Sletten/STM_Perf/Hardware/BOM.txt

List of components used in the perf module, divided into each pcb.

Motherboard:
STM32F100ZET6B		x3
http://no.farnell.com/stmicroelectronics/stm32f100zet6b/mcu-32bit-cortex-m3-24mhz-lqfp/dp/1898999

-EEPROM
24LC256-I/SN 256Kb	x3
http://no.farnell.com/microchip/24lc256-i-sn/serial-eeprom-256kbit-400khz-soic/dp/9757996

-3.3V regulator		x3
TEXAS INSTRUMENTS  LM2937IMP-3.3/NOPB  LDO REGULATOR, 3.3V, 0.5A, 3SOT223
http://no.farnell.com/texas-instruments/lm2937imp-3-3-nopb/ldo-regulator-3-3v-0-5a-3sot223/dp/2296021

-thruster levelshift
SN74LVCC4245APWR	x3
http://no.farnell.com/texas-instruments/sn74lvcc4245apwr/ic-8bit-bus-transceiver-tssop/dp/2342538

crystall		x3

http://no.farnell.com/abracon/abl-24-000mhz-b2/crystal-24m-18pf-cl-hc49-4h/dp/1611782

LEd

green 	x10
http://no.farnell.com/kingbright/kpt-3216sgc/led-1206-green-12mcd-568nm/dp/2099247

red	x10
http://no.farnell.com/kingbright/kpt-3216ec/led-1206-red-15mcd-625nm/dp/2099245

yellow	x5
http://no.farnell.com/kingbright/kpt-3216syck/led-yellow-1206-smd/dp/2099249

orange	x5
http://no.farnell.com/kingbright/kpt-3216seck/led-orange-1206-smd/dp/2099246

Resistor

4,7k 	x 20
http://no.farnell.com/multicomp/mcwr12x4701ftl/res-thick-film-4-7kohm-1-0-25w/dp/2447523

64,9 	x 20
http://no.farnell.com/multicomp/mc0125w1206164r9/resistor-64r9-0-125w-1-1206/dp/2142125

140	x20
http://no.farnell.com/multicomp/mc0125w12061140r/resistor-140r-0-125w-1-1206/dp/2142139

150	x20
http://no.farnell.com/multicomp/mc0125w12061150r/resistor-150r-0-125w-1-1206/dp/9335943

56	x20
http://no.farnell.com/multicomp/mc0125w1206156r/resistor-56r-0-125w-1-1206/dp/9336702

59	x20
http://no.farnell.com/multicomp/mc0125w1206159r0/resistor-59r-0-125w-1-1206/dp/2142123

Capasitor

100n 	x40
http://no.farnell.com/multicomp/mc0805b104k500ct/cap-mlcc-x7r-100nf-50v-0805/dp/1759265
10µ	x15
http://no.farnell.com/multicomp/mc0805x106k250ct/cap-mlcc-x5r-10uf-25v-0805/dp/2320833
27p	x20
http://no.farnell.com/multicomp/mc0805n270j500ct/cap-mlcc-c0g-np0-27pf-50v-0805/dp/1759196
1µ	x10
http://no.farnell.com/kemet/c0805c105k3ractu/cap-mlcc-x7r-1uf-25v-0805/dp/2395779
10n	x10
http://no.farnell.com/multicomp/mc0805b103k500ct/cap-mlcc-x7r-10nf-50v-0805/dp/1759246

Pin Headers:

4x1 header	x10
http://no.farnell.com/multicomp/2211s-04g/connector-header-tht-2-54mm-4way/dp/1593413

20x2 socket 	x6
http://no.farnell.com/harwin/m20-7832046/socket-pcb-0-1-20-20way/dp/7992033
header		x4
http://no.farnell.com/molex/10-89-7402/connector-header-40pos-2row-2/dp/2396214

3x2 socket	x10
http://no.farnell.com/multicomp/2213s-06g/header-2-row-vert-6way/dp/1593440
header		x5
http://no.farnell.com/multicomp/2214s-06sg-85/connector-receptacle-pcb-2-54mm/dp/1593488

2x16		x10
http://no.farnell.com/samtec/ces-116-01-t-d/receptacle-2-54mm-dual-32way/dp/1667521
		x10
http://no.farnell.com/wurth-elektronik/61303221021/header-2-54mm-pin-tht-r-a-32way/dp/2356204

connectors
Headers

2pin	x2
http://no.farnell.com/multicomp/mc000128/terminal-block-header-2pos-th/dp/2008108

5pin	x4
http://no.farnell.com/multicomp/mc000131/terminal-block-header-5pos-th/dp/2008111

10pin	x2
http://no.farnell.com/multicomp/mc000134/terminal-block-header-10pos-th/dp/2008114

pluggable

2pin	x2
http://no.farnell.com/multicomp/mc000096/terminal-block-pluggable-2pos/dp/2008072

5pin	x4
http://no.farnell.com/multicomp/mc000099/terminal-block-pluggable-5pos/dp/2008076

10pin	x2
http://no.farnell.com/multicomp/mc000102/terminal-block-pluggable-10pos/dp/2008079

Backplane:

Power:

Com:

manip:

light:

aux1:

aux2:
