Sletten/STM_Perf/Documentation/communication protocol.txt

communication protocol for PERF module, based on MIP data communications protocol.

Packet overciew

	Header

-Start of Packet (SOP)
One or two bytes of bit sequence, (characters) to innitiate the start of a packet
Startbyte 1: 155
Startbyte 2: 185

-Data type byte
Two bytes describing what type of data is being sendt.
First one byte describing command type
- COMMAND		Genreal system commands, retrieving info, performing system test, and such
- CONTROL		Controlling systems, like thruster, manip, light
- SENSOR		Retrieving data from sensor
- SYSTEM PARAMETER	Setting and reading system parameters stored in eeprom

Then one byte to describe what system to connect with.

- Thruster
- Manipulator
- Light
- Camera

-Payload Length byte
One byte which value indicates how many bytes is contained in the Payload.
Counting onlye the number of data bytes sendt, not to include the start header(startbytes, datatype, and length), or the checksum bytes

	Payload

-Payload header
applicable if data type indicates several types of data is sendt.
Data type byte, same as above.
Data length, the length of this payload chunk

-Payload data
The data sendt as payload, length described by previous byte.

	Checksum
Two bytes for checksum, might use 16-bit fletch checksum as described in the MIP reference

Table of data types:

commands		0x01
	Get system info
	get version
	get status

-Control		0x08
	thruster	0x11	- 6 bytes
		x y z axis
		yaw pitch roll rotation
	manip		0x13
		channel number, 1 byte - 8 possible active, (eg: 00101101, ch 1, 3, 4, 6 active)
		movement, speed/ set position/ force - givven by previous setup
	light		0x15
		channel number, 1 byte - 8 possible active, (eg: 00101101, ch 1, 3, 4, 6 active)
		set dim, two channels in one byte, 4bits per light channel.
	camera		0x17
		channel number, 1 byte - 8 possible active, (eg: 00101101, ch 1, 3, 4, 6 active)
		set position/ speed givven by setup.
		focus / zoom / other
	other		0x1F

-sensor				0x0F
	request data - one value for each type of equipment.
		-sonar
		-altimeter
		-imu

-system parameters	0x10 - set for now, 0x11 for save to eeprom
	thruster		0x11
		channel number, 1 byte - 8 possible active, (eg: 00101101, ch 1, 3, 4, 6 active)
		set midpoint
		set endpoint
		set deadzone
		set max power/thrust/
		set thrust vectoring
		set 
	manip			0x13
		channel number, 1 byte - 8 possible active, (eg: 00101101, ch 1, 3, 4, 6 active)
		set actuator type (motor/servo/stepper) // is this usefull? PERF firmware controls manip fuctionalyty anyways.
		set enpoints
		set max speed/power/
		set midpoint
		set 
	light			0x15
	camera			0x17
	other			0x1F

Thruster
