Sletten/STM_Perf/Hardware/KiCad/Perf/MB/New Folder/snapshot_a00.png

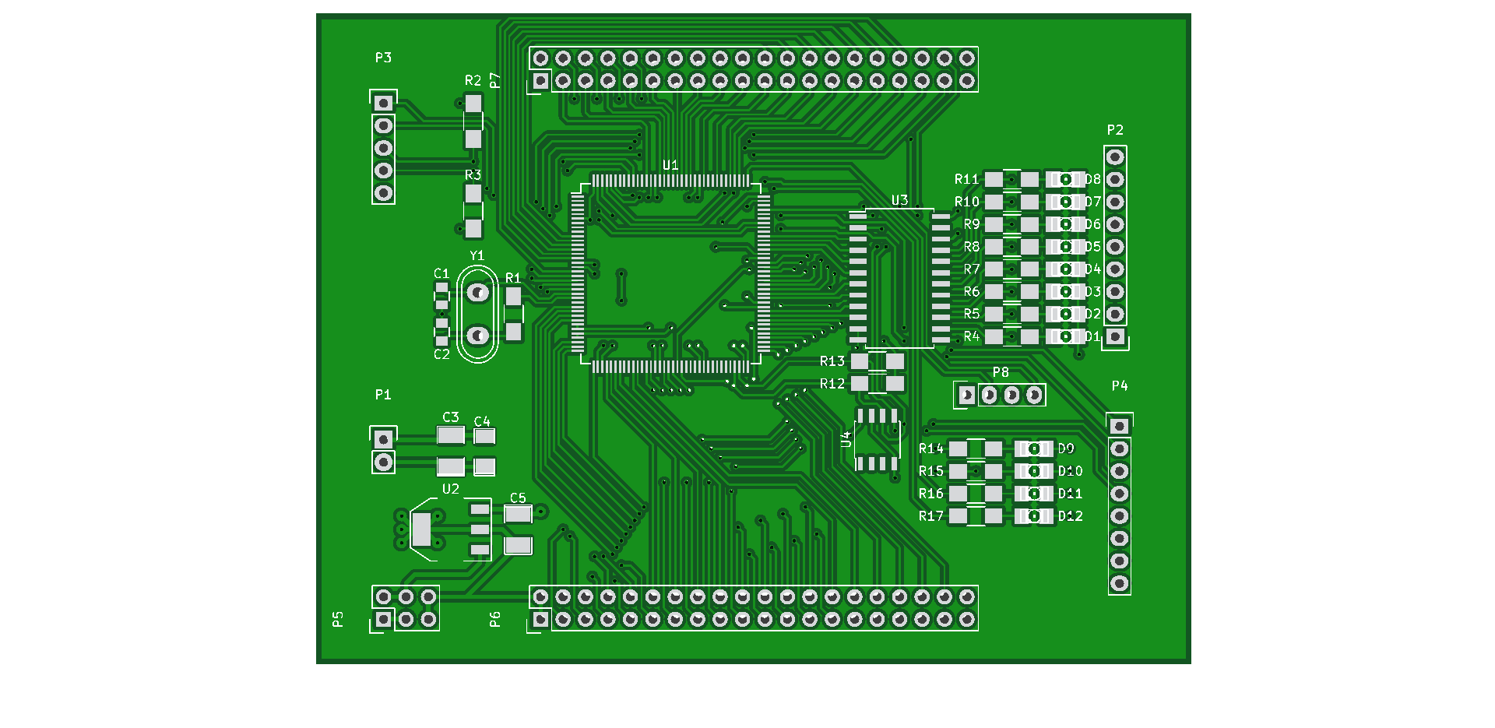
Hardware/KiCad/Perf/MB/New Folder/snapshot_a00.png
