Sletten/STM_Perf/Hardware/KiCad/Perf/MB/Motherboard.stl

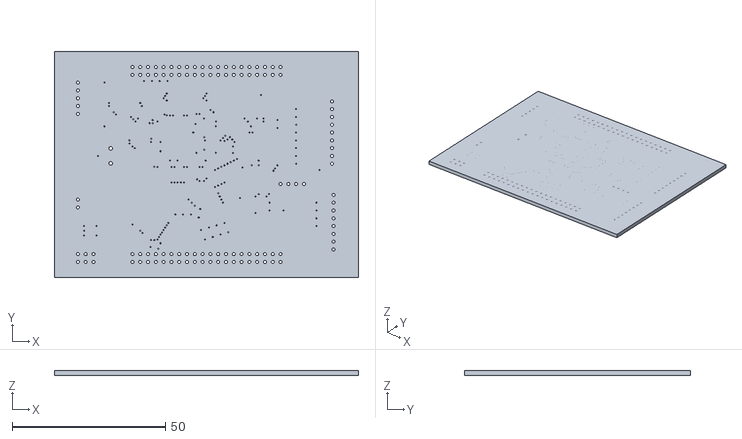
[picture p2: CAD file, 2015-05-25]
Hardware/KiCad/Perf/MB/Motherboard.stl
99.1 x 73.7 x 1.70
