Sletten/STM_Perf/(list of files, cad)

Other CAD files:
Hardware/KiCad/Perf/MB/New Folder/Motherboard.ply
