Sletten/STM_Perf/Hardware/KiCad/Perf/MB/New Folder/Motherboard-B_Cu.pdf

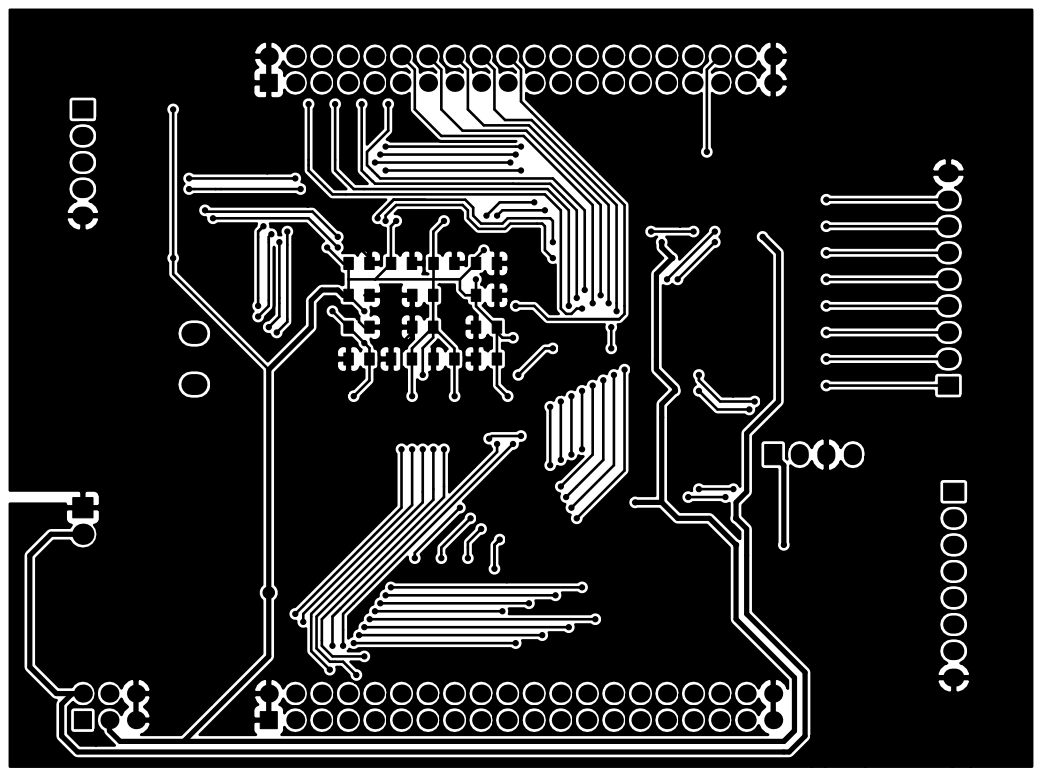
[picture p3: page 1]
