Sletten/STM_Perf/Hardware/KiCad/Perf/MB/New Folder/Motherboard-B_Mask.pdf

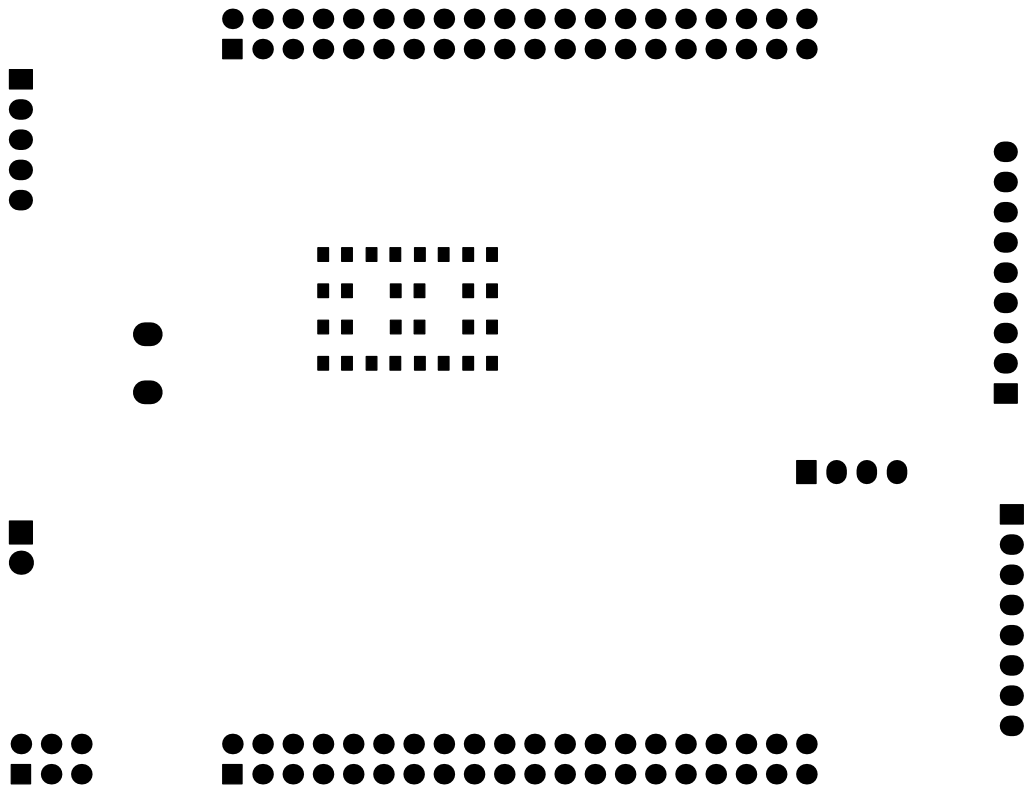
[picture p4: page 1]
