Sletten/STM_Perf/Hardware/KiCad/Perf/MB/New Folder/Motherboard-B_SilkS.pdf

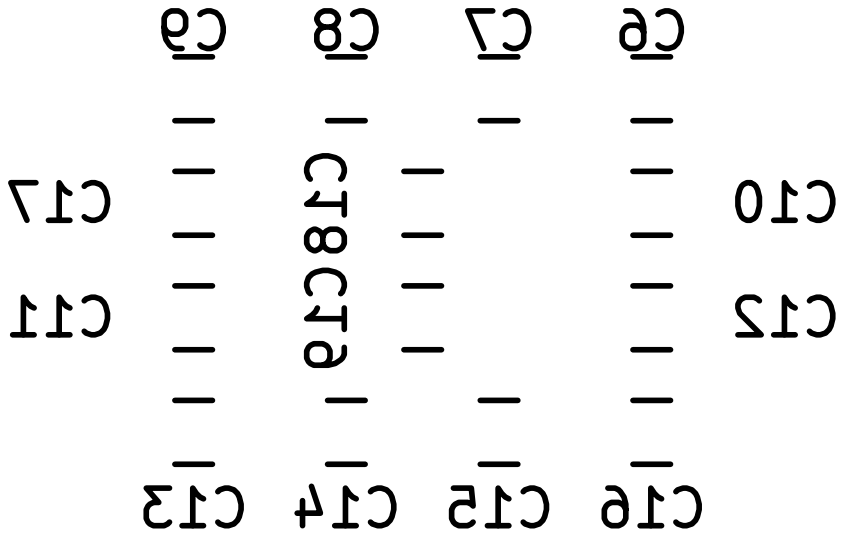
[picture p5: page 1]
