Sletten/STM_Perf/Hardware/KiCad/Perf/MB/New Folder/Motherboard-F_Cu.pdf

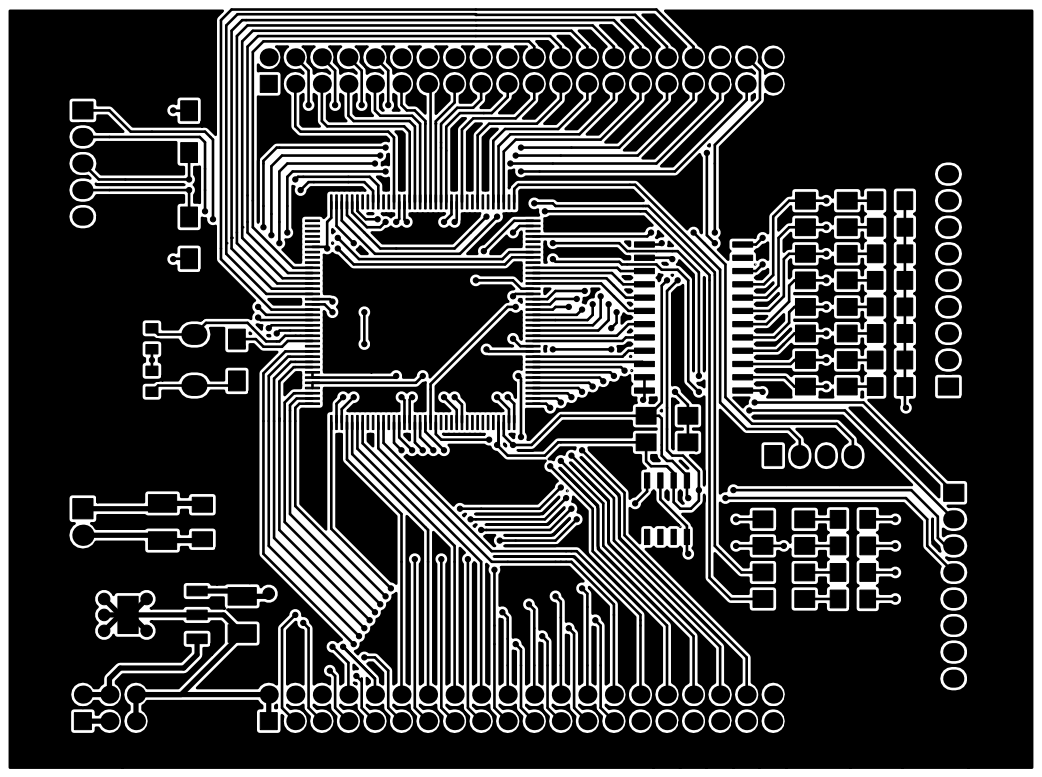
[picture p6: page 1]
