Sletten/STM_Perf/Hardware/KiCad/Perf/MB/New Folder/Motherboard-F_Mask.pdf

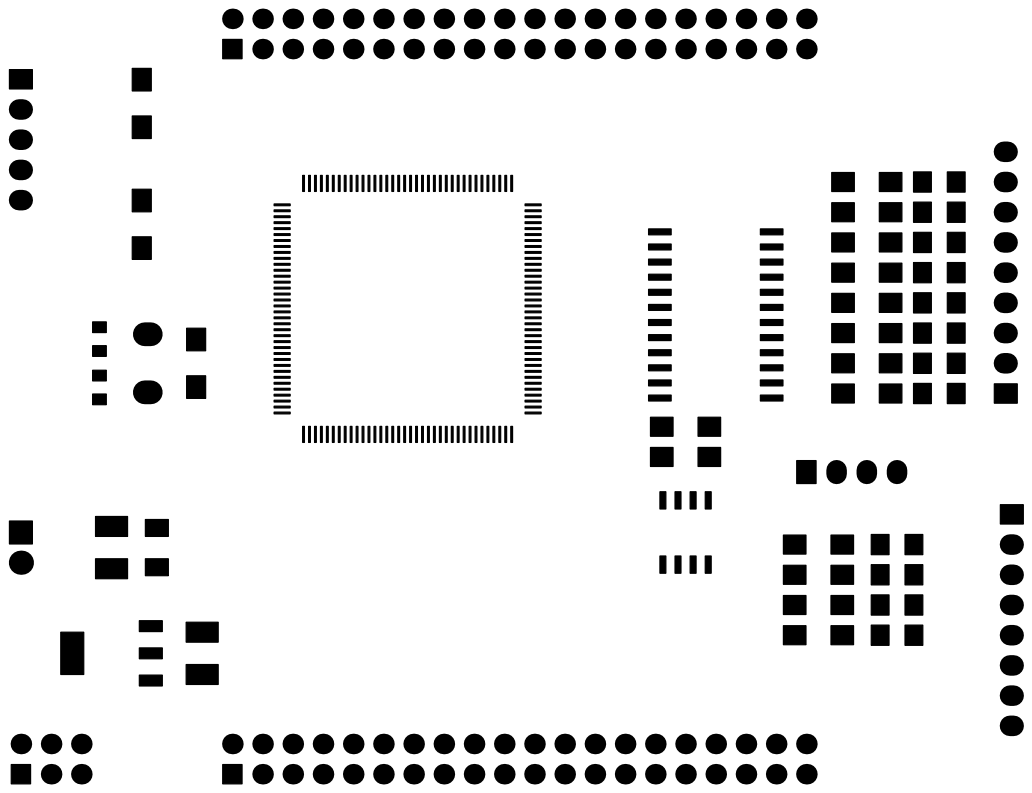
[picture p7: page 1]
