Sletten/STM_Perf/Hardware/KiCad/Perf/MB/New Folder/Motherboard-F_SilkS.pdf

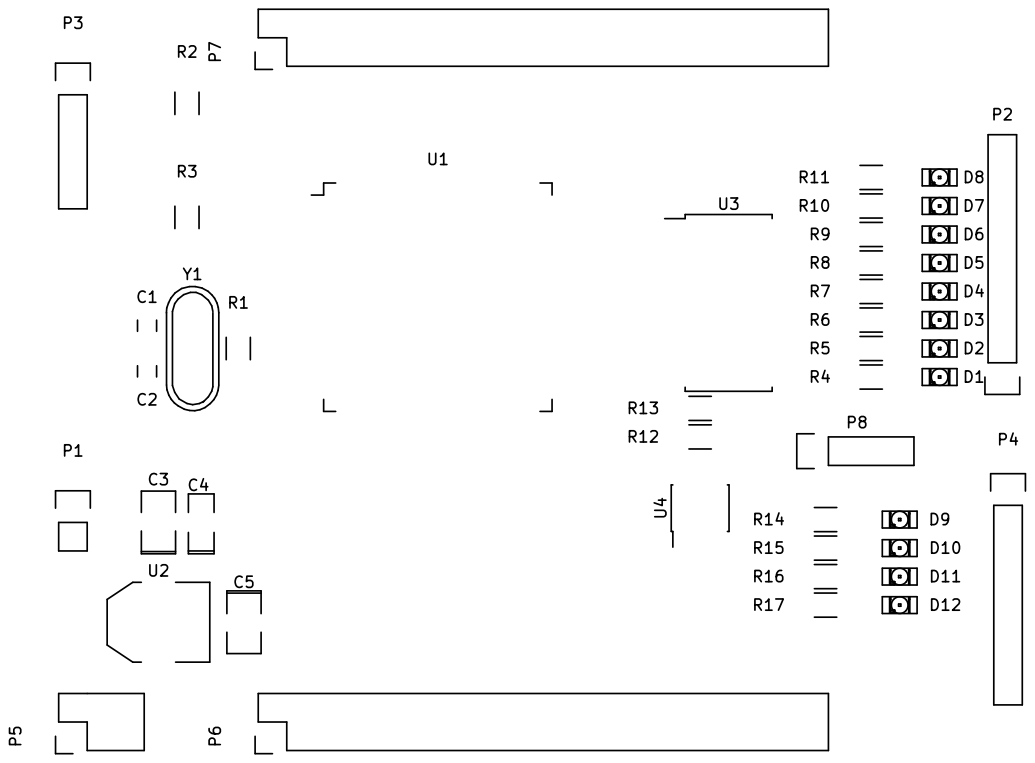
[picture p8: page 1]
