Sletten/STM_Perf/Hardware/KiCad/Perf/Gerber/MB/temp/Motherboard-B.Cu.pdf

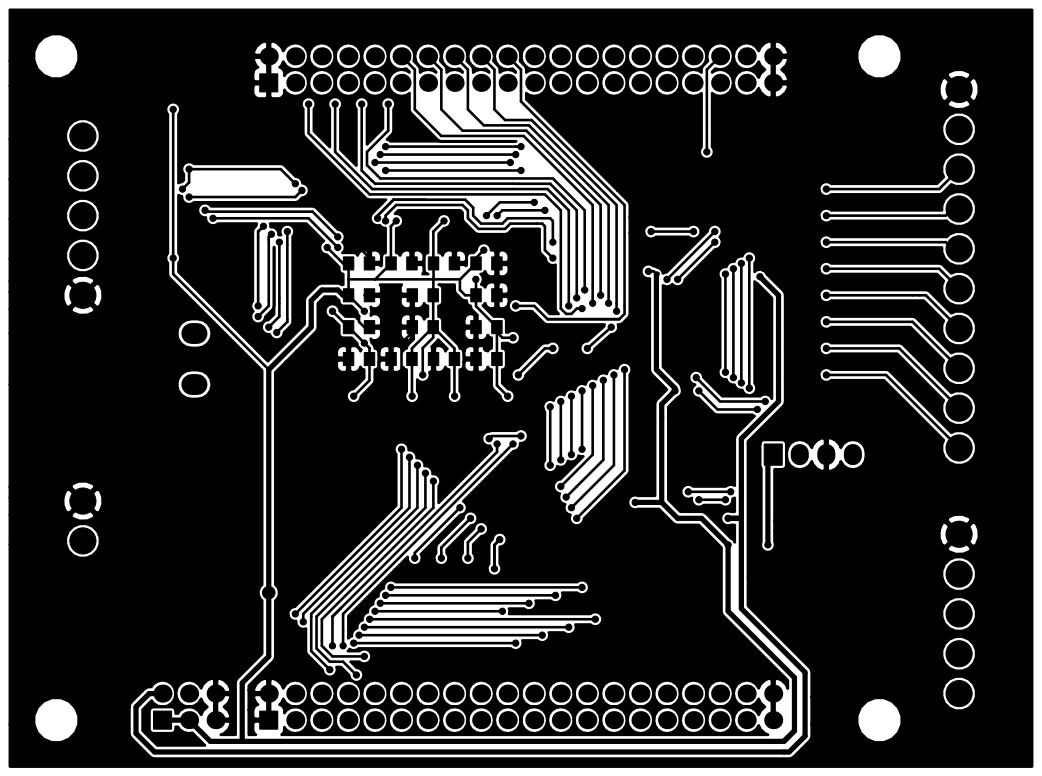
[picture p9: page 1]
