Sletten/STM_Perf/Hardware/KiCad/Perf/Gerber/MB/temp/Motherboard-B.Mask.pdf

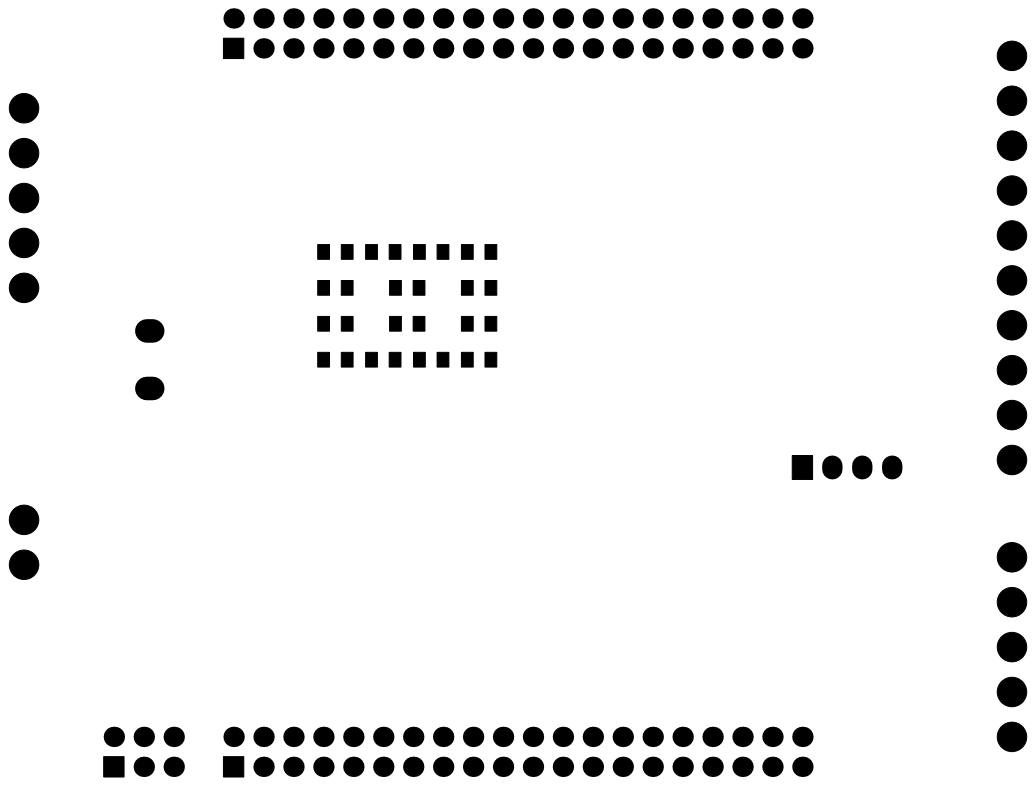
[picture p10: page 1]
