Sletten/STM_Perf/Hardware/KiCad/Perf/Gerber/MB/temp/Motherboard-B.SilkS.pdf

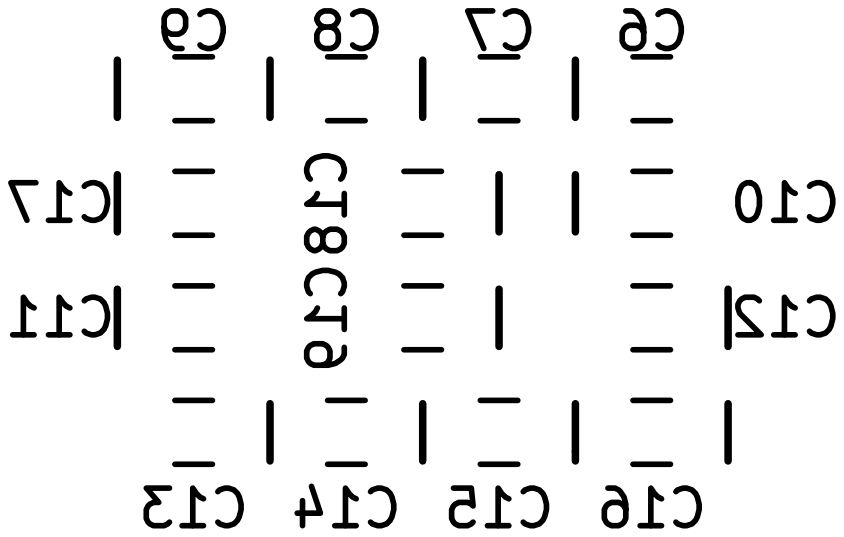
[picture p11: page 1]
