Sletten/STM_Perf/Hardware/KiCad/Perf/Gerber/MB/temp/Motherboard-Cmts.User.pdf

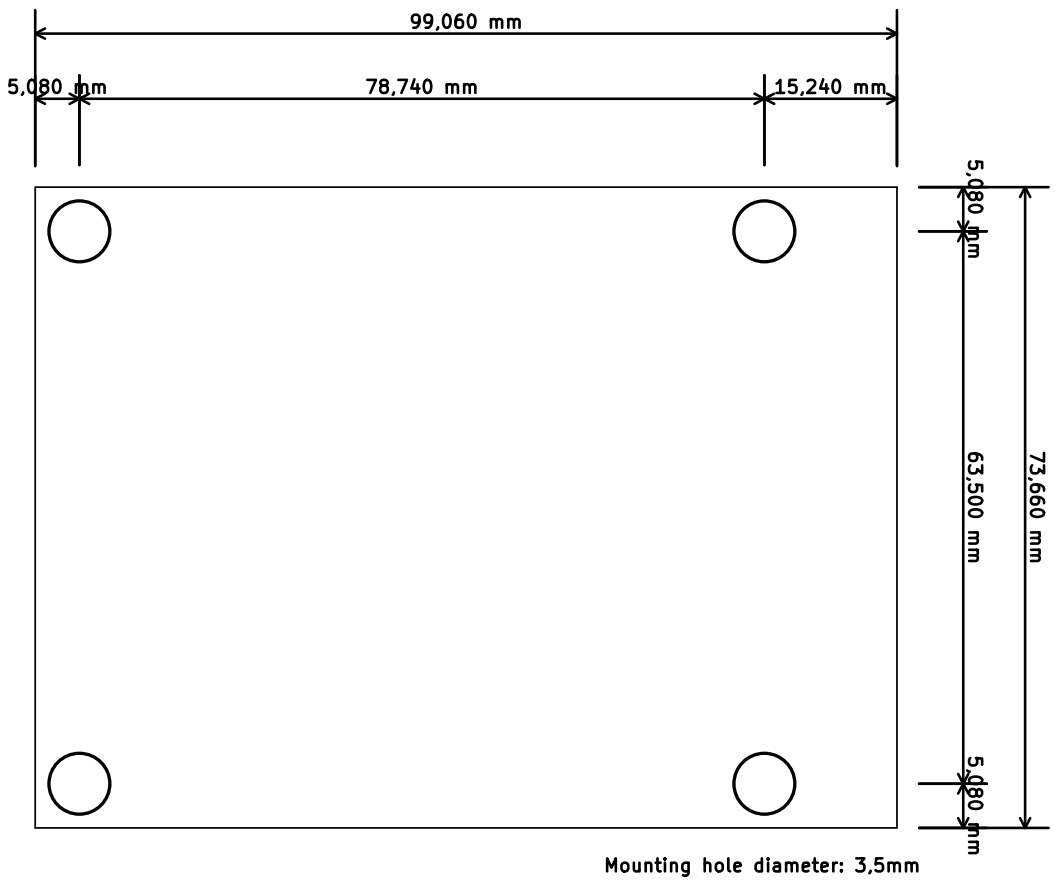
[picture p12: page 1]
