Sletten/STM_Perf/Hardware/KiCad/Perf/Gerber/MB/temp/Motherboard-F.Cu.pdf

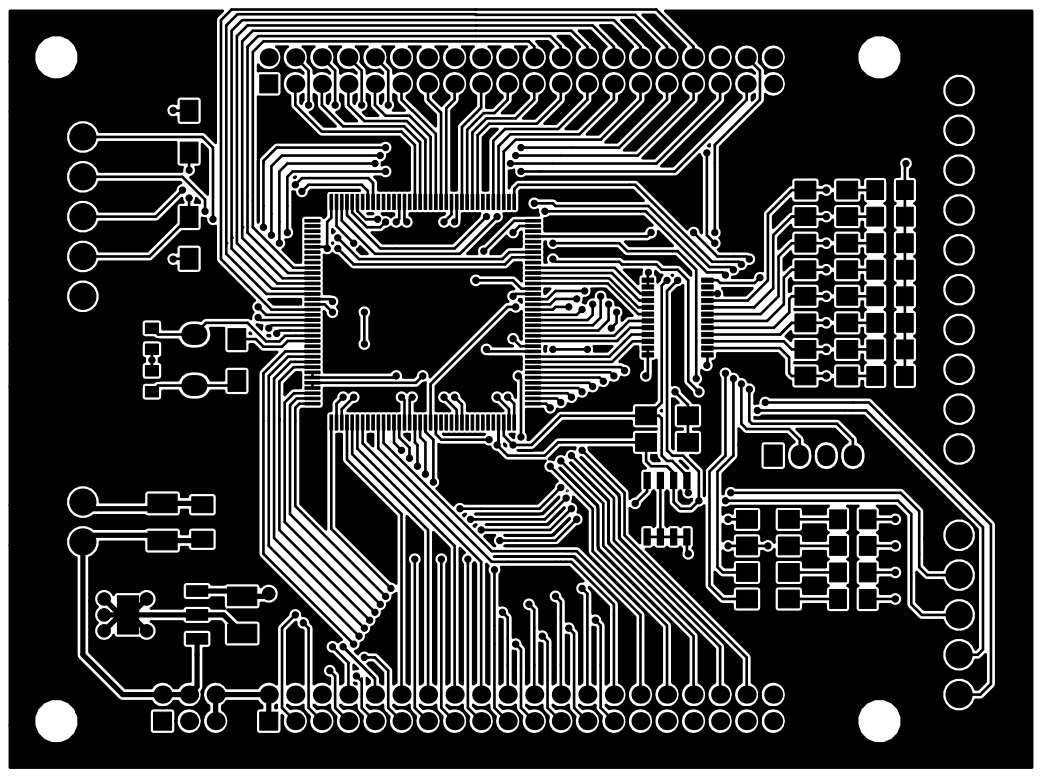
[picture p13: page 1]
