Sletten/STM_Perf/Hardware/KiCad/Perf/Gerber/MB/temp/Motherboard-F.Mask.pdf

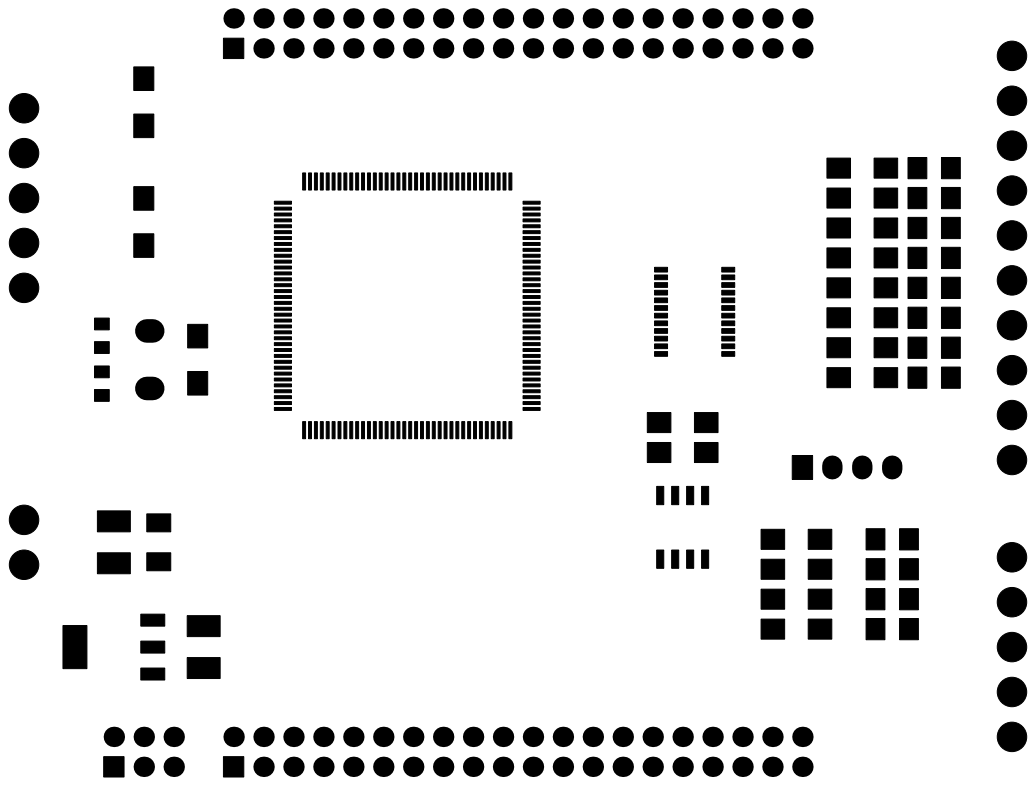
[picture p14: page 1]
