Sletten/STM_Perf/Hardware/KiCad/Perf/Gerber/MB/temp/Motherboard-F.SilkS.pdf

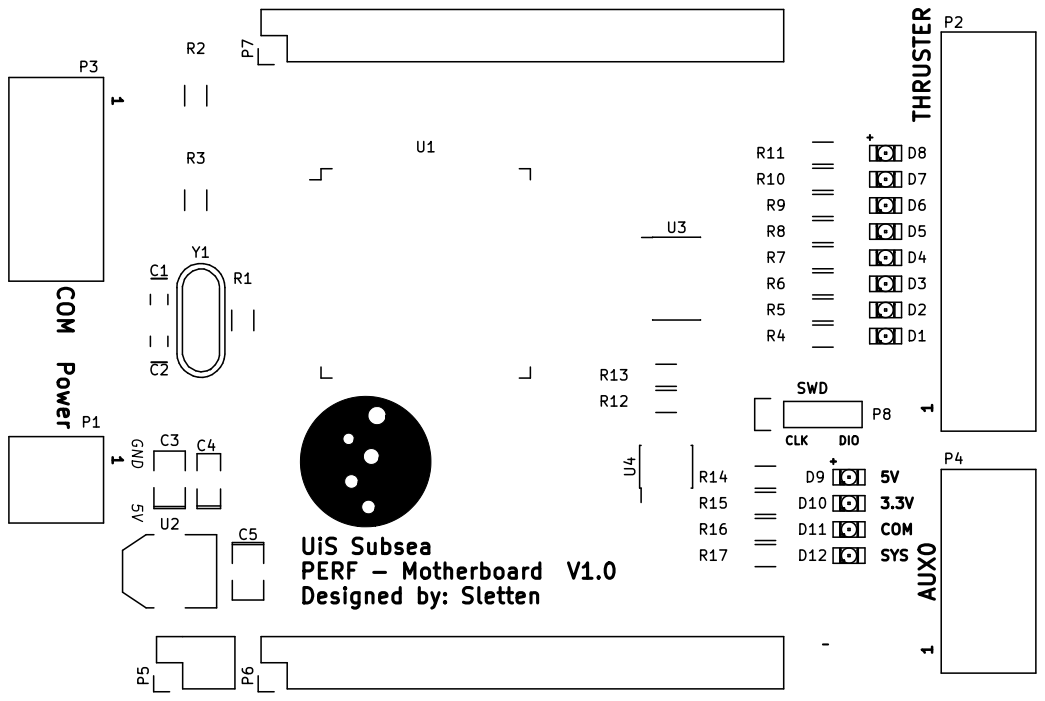
[picture p15: page 1]
