Sletten/STM_Perf/Hardware/KiCad/Perf/MB/Motherboard.kicad_pcb

## KiCad design Hardware/KiCad/Perf/MB/Motherboard.kicad_pcb (2016-05-06)

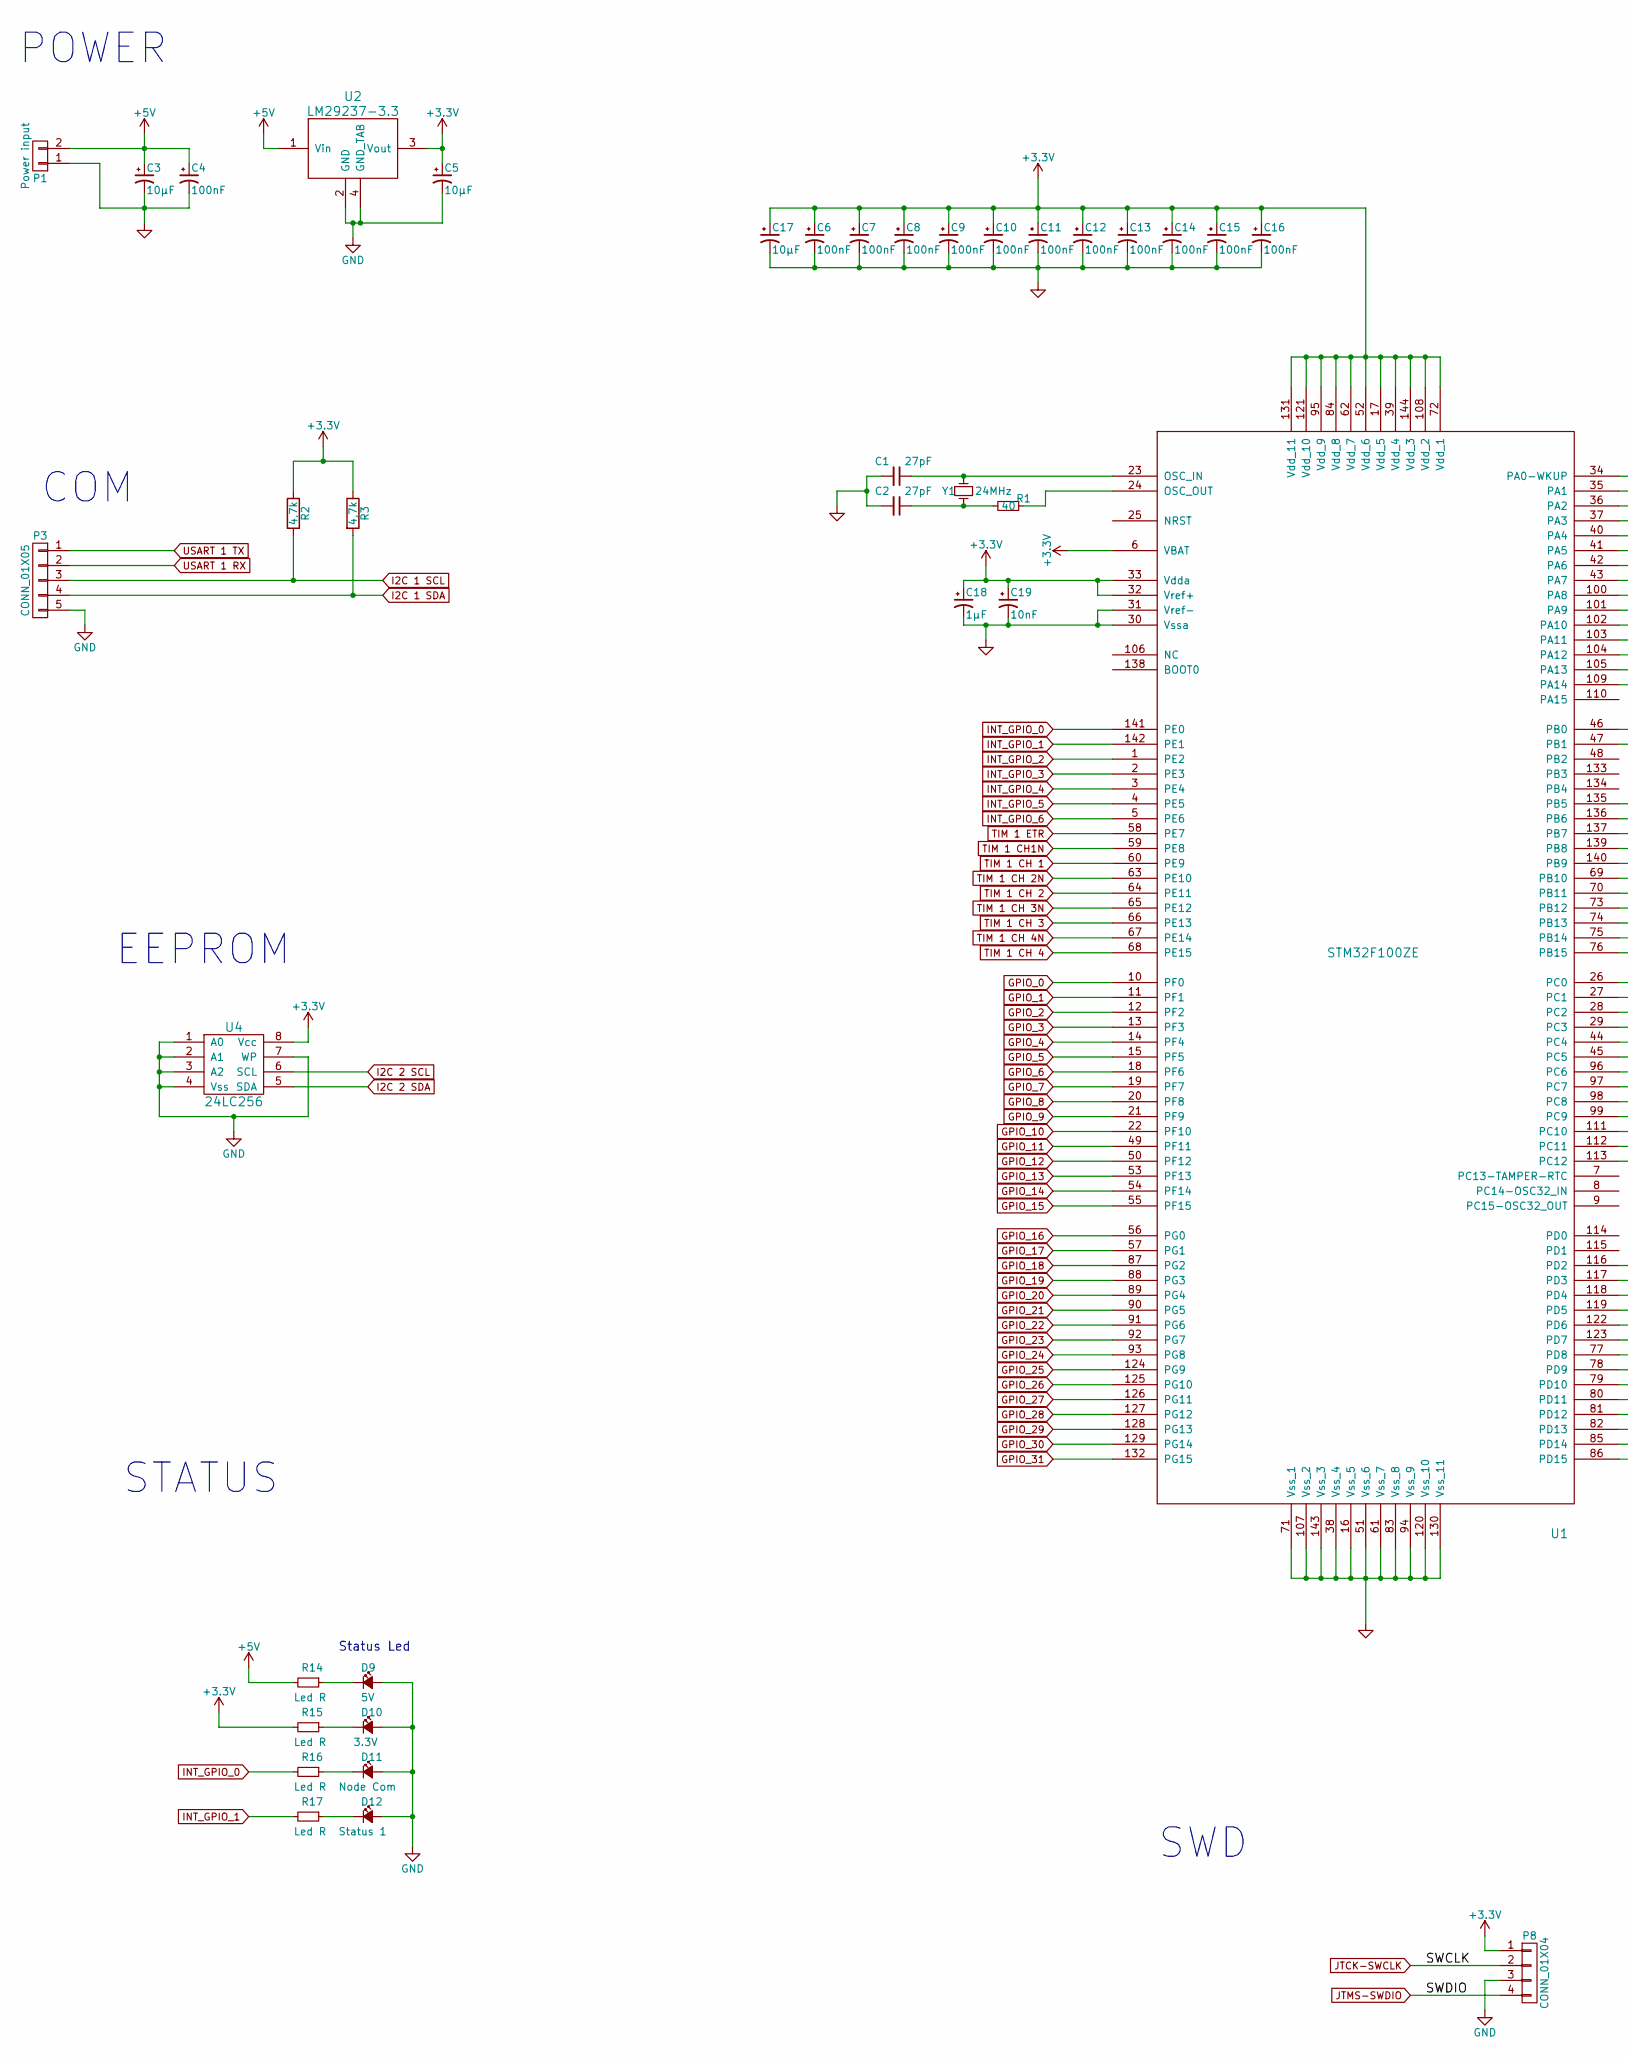
[picture p16: schematic Motherboard.sch, part in row 1, column 1]

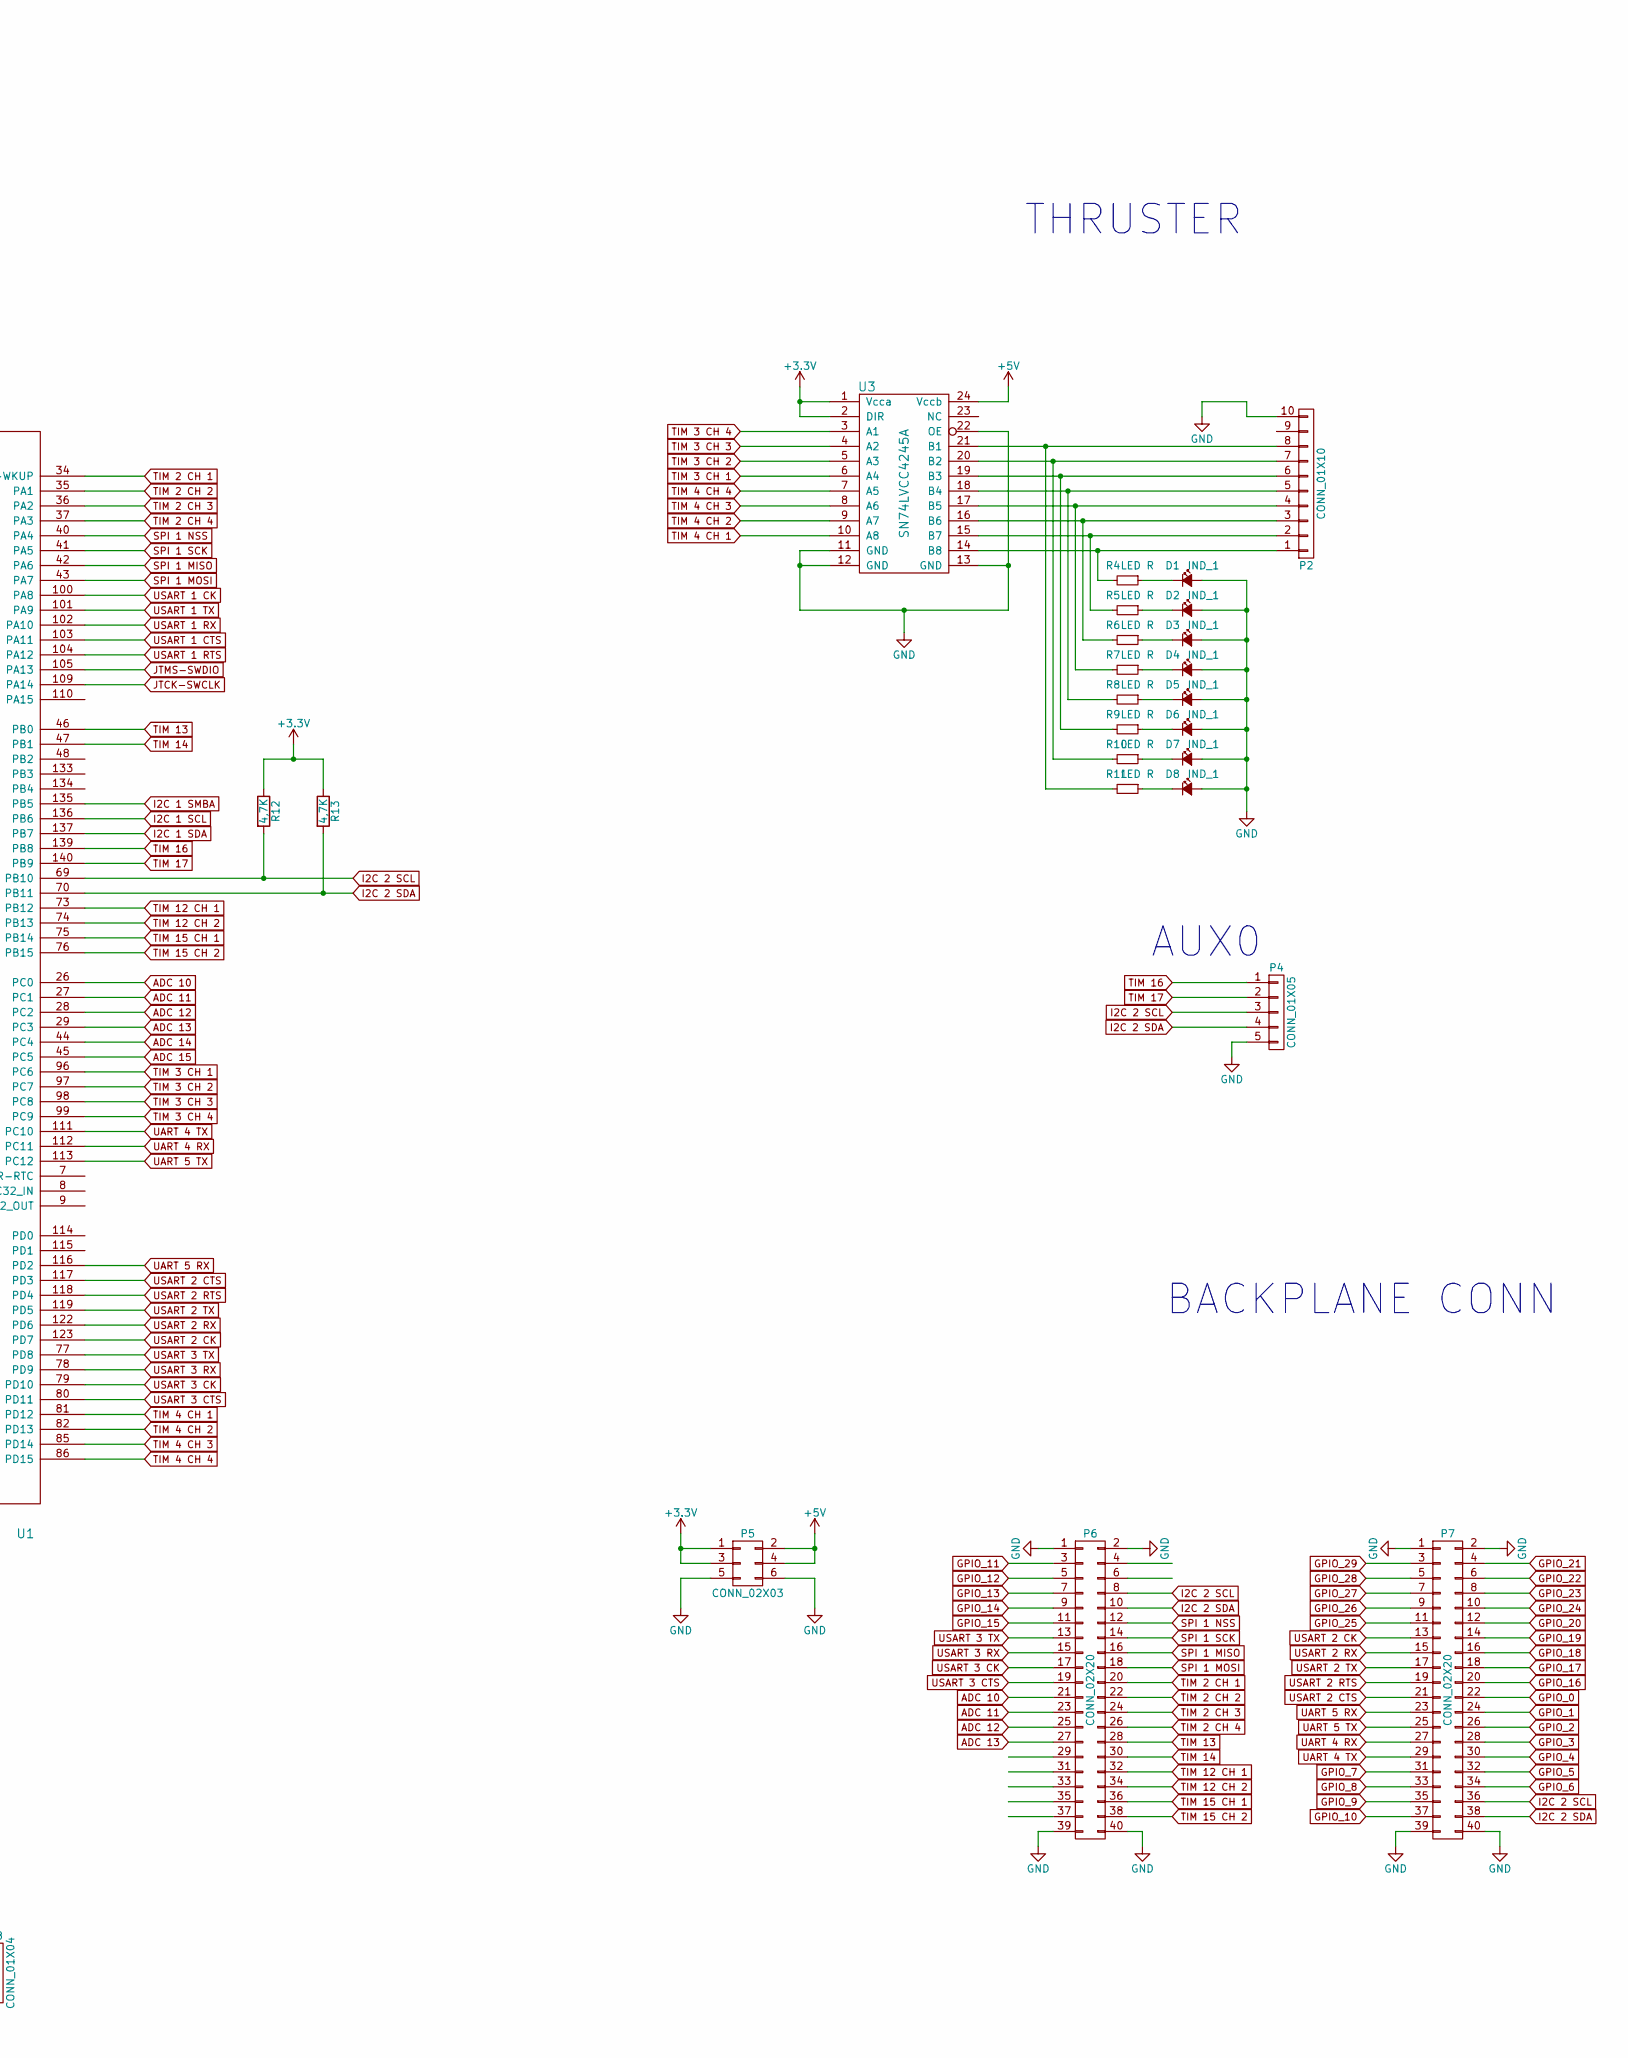
[picture p17: schematic Motherboard.sch, part in row 1, column 2]

Parts:
C1, C2: 27pF
C3, C5, C17: 10µF
C4, C6, C7, C8, C9, C10, C11, C12, C13, C14, C15, C16: 100nF
C18: 1µF
C19: 10nF
D1, D2, D3, D4, D5, D6, D7, D8: IND_1
D9: 5V
D10: 3.3V
D11: Node Com
D12: Status 1
P1: Power input
P2: CONN_01X10
P3, P4: CONN_01X05
P5: CONN_02X03
P6, P7: CONN_02X20
P8: CONN_01X04
R1: 40
R2, R3: 4,7k
R4, R5, R6, R7, R8, R9, R10, R11: LED R
R12, R13: 4,7K
R14, R15, R16, R17: Led R
U1: STM32F100ZE
U2: LM29237-3.3
U3: SN74LVCC4245A
U4: 24LC256
Y1: 24MHz

Connections:
+3V3: C5.1, C6.1, C7.1, C8.1, C9.1, C10.1, C11.1, C12.1, C13.1, C14.1, C15.1, C16.1, C17.1, C18.1, C19.1, P5.1, P5.3, P8.1, R2.1, R3.1, R12.1, R13.1, R15.2, U1.6 (VBAT), U1.17 (Vdd_5), U1.32 (Vref+), U1.33 (Vdda), U1.39 (Vdd_4), U1.52 (Vdd_6), U1.62 (Vdd_7), U1.72 (Vdd_1), U1.84 (Vdd_8), U1.95 (Vdd_9), U1.108 (Vdd_2), U1.121 (Vdd_10), U1.131 (Vdd_11), U1.144 (Vdd_3), U2.3 (Vout), U3.1 (Vcca), U3.2 (DIR), U4.8 (Vcc)
+5V: C3.1, C4.1, P1.2, P5.2, P5.4, R14.2, U2.1 (Vin), U3.24 (Vccb)
ADC 10: P6.21, U1.26 (PC0)
ADC 11: P6.23, U1.27 (PC1)
ADC 12: P6.25, U1.28 (PC2)
ADC 13: P6.27, U1.29 (PC3)
ADC 14: U1.44 (PC4)
ADC 15: U1.45 (PC5)
GND: C1.2, C2.2, C3.2, C4.2, C5.2, C6.2, C7.2, C8.2, C9.2, C10.2, C11.2, C12.2, C13.2, C14.2, C15.2, C16.2, C17.2, C18.2, C19.2, D1.2 (A), D2.2 (A), D3.2 (A), D4.2 (A), D5.2 (A), D6.2 (A), D7.2 (A), D8.2 (A), D9.2 (A), D10.2 (A), D11.2 (A), D12.2 (A), P1.1, P2.10, P3.5, P4.5, P5.5, P5.6, P6.1, P6.2, P6.39, P6.40, P7.1, P7.2, P7.39, P7.40, P8.3, U1.16 (Vss_5), U1.30 (Vssa), U1.31 (Vref-), U1.38 (Vss_4), U1.51 (Vss_6), U1.61 (Vss_7), U1.71 (Vss_1), U1.83 (Vss_8), U1.94 (Vss_9), U1.107 (Vss_2), U1.120 (Vss_10), U1.130 (Vss_11), U1.143 (Vss_3), U2.2 (GND), U2.4 (GND_TAB), U3.11 (GND), U3.12 (GND), U3.13 (GND), U3.22 (OE), U4.1 (A0), U4.2 (A1), U4.3 (A2), U4.4 (Vss), U4.7 (WP)
GPIO_0: P7.22, U1.10 (PF0)
GPIO_1: P7.24, U1.11 (PF1)
GPIO_2: P7.26, U1.12 (PF2)
GPIO_3: P7.28, U1.13 (PF3)
GPIO_4: P7.30, U1.14 (PF4)
GPIO_5: P7.32, U1.15 (PF5)
GPIO_6: P7.34, U1.18 (PF6)
GPIO_7: P7.31, U1.19 (PF7)
GPIO_8: P7.33, U1.20 (PF8)
GPIO_9: P7.35, U1.21 (PF9)
GPIO_10: P7.37, U1.22 (PF10)
GPIO_11: P6.3, U1.49 (PF11)
GPIO_12: P6.5, U1.50 (PF12)
GPIO_13: P6.7, U1.53 (PF13)
GPIO_14: P6.9, U1.54 (PF14)
GPIO_15: P6.11, U1.55 (PF15)
GPIO_16: P7.20, U1.56 (PG0)
GPIO_17: P7.18, U1.57 (PG1)
GPIO_18: P7.16, U1.87 (PG2)
GPIO_19: P7.14, U1.88 (PG3)
GPIO_20: P7.12, U1.89 (PG4)
GPIO_21: P7.4, U1.90 (PG5)
GPIO_22: P7.6, U1.91 (PG6)
GPIO_23: P7.8, U1.92 (PG7)
GPIO_24: P7.10, U1.93 (PG8)
GPIO_25: P7.11, U1.124 (PG9)
GPIO_26: P7.9, U1.125 (PG10)
GPIO_27: P7.7, U1.126 (PG11)
GPIO_28: P7.5, U1.127 (PG12)
GPIO_29: P7.3, U1.128 (PG13)
GPIO_30: U1.129 (PG14)
GPIO_31: U1.132 (PG15)
I2C 1 SCL: P3.3, R2.2, U1.136 (PB6)
I2C 1 SDA: P3.4, R3.2, U1.137 (PB7)
I2C 1 SMBA: U1.135 (PB5)
I2C 2 SCL: P4.3, P6.8, P7.36, R12.2, U1.69 (PB10), U4.6 (SCL)
I2C 2 SDA: P4.4, P6.10, P7.38, R13.2, U1.70 (PB11), U4.5 (SDA)
INT_GPIO_0: R16.2, U1.141 (PE0)
INT_GPIO_1: R17.2, U1.142 (PE1)
INT_GPIO_2: U1.1 (PE2)
INT_GPIO_3: U1.2 (PE3)
INT_GPIO_4: U1.3 (PE4)
INT_GPIO_5: U1.4 (PE5)
INT_GPIO_6: U1.5 (PE6)
JTCK-SWCLK: P8.2, U1.109 (PA14)
JTMS-SWDIO: P8.4, U1.105 (PA13)
unnamed: C1.1, U1.23 (OSC_IN), Y1.1
unnamed: C2.1, R1.2, Y1.2
unnamed: D1.1 (K), R4.1
unnamed: D2.1 (K), R5.1
unnamed: D3.1 (K), R6.1
unnamed: D4.1 (K), R7.1
unnamed: D5.1 (K), R8.1
unnamed: D6.1 (K), R9.1
unnamed: D7.1 (K), R10.1
unnamed: D8.1 (K), R11.1
unnamed: D9.1 (K), R14.1
unnamed: D10.1 (K), R15.1
unnamed: D11.1 (K), R16.1
unnamed: D12.1 (K), R17.1
unnamed: P2.1, R4.2, U3.14 (B8)
unnamed: P2.2, R5.2, U3.15 (B7)
unnamed: P2.3, R6.2, U3.16 (B6)
unnamed: P2.4, R7.2, U3.17 (B5)
unnamed: P2.5, R8.2, U3.18 (B4)
unnamed: P2.6, R9.2, U3.19 (B3)
unnamed: P2.7, R10.2, U3.20 (B2)
unnamed: P2.8, R11.2, U3.21 (B1)
unnamed: R1.1, U1.24 (OSC_OUT)
SPI 1 MISO: P6.16, U1.42 (PA6)
SPI 1 MOSI: P6.18, U1.43 (PA7)
SPI 1 NSS: P6.12, U1.40 (PA4)
SPI 1 SCK: P6.14, U1.41 (PA5)
TIM 1 CH1N: U1.59 (PE8)
TIM 1 CH 1: U1.60 (PE9)
TIM 1 CH 2: U1.64 (PE11)
TIM 1 CH 2N: U1.63 (PE10)
TIM 1 CH 3: U1.66 (PE13)
TIM 1 CH 3N: U1.65 (PE12)
TIM 1 CH 4: U1.68 (PE15)
TIM 1 CH 4N: U1.67 (PE14)
TIM 1 ETR: U1.58 (PE7)
TIM 2 CH 1: P6.20, U1.34 (PA0-WKUP)
TIM 2 CH 2: P6.22, U1.35 (PA1)
TIM 2 CH 3: P6.24, U1.36 (PA2)
TIM 2 CH 4: P6.26, U1.37 (PA3)
TIM 3 CH 1: U1.96 (PC6), U3.6 (A4)
TIM 3 CH 2: U1.97 (PC7), U3.5 (A3)
TIM 3 CH 3: U1.98 (PC8), U3.4 (A2)
TIM 3 CH 4: U1.99 (PC9), U3.3 (A1)
TIM 4 CH 1: U1.81 (PD12), U3.10 (A8)
TIM 4 CH 2: U1.82 (PD13), U3.9 (A7)
TIM 4 CH 3: U1.85 (PD14), U3.8 (A6)
TIM 4 CH 4: U1.86 (PD15), U3.7 (A5)
TIM 12 CH 1: P6.32, U1.73 (PB12)
TIM 12 CH 2: P6.34, U1.74 (PB13)
TIM 13: P6.28, U1.46 (PB0)
TIM 14: P6.30, U1.47 (PB1)
TIM 15 CH 1: P6.36, U1.75 (PB14)
TIM 15 CH 2: P6.38, U1.76 (PB15)
TIM 16: P4.1, U1.139 (PB8)
TIM 17: P4.2, U1.140 (PB9)
UART 4 RX: P7.27, U1.112 (PC11)
UART 4 TX: P7.29, U1.111 (PC10)
UART 5 RX: P7.23, U1.116 (PD2)
UART 5 TX: P7.25, U1.113 (PC12)
USART 1 CK: U1.100 (PA8)
USART 1 CTS: U1.103 (PA11)
USART 1 RTS: U1.104 (PA12)
USART 1 RX: P3.2, U1.102 (PA10)
USART 1 TX: P3.1, U1.101 (PA9)
USART 2 CK: P7.13, U1.123 (PD7)
USART 2 CTS: P7.21, U1.117 (PD3)
USART 2 RTS: P7.19, U1.118 (PD4)
USART 2 RX: P7.15, U1.122 (PD6)
USART 2 TX: P7.17, U1.119 (PD5)
USART 3 CK: P6.17, U1.79 (PD10)
USART 3 CTS: P6.19, U1.80 (PD11)
USART 3 RX: P6.15, U1.78 (PD9)
USART 3 TX: P6.13, U1.77 (PD8)

Notes on the sheet:
POWER
COM
THRUSTER
AUX0
BACKPLANE CONN
EEPROM
STATUS
Status Led
SWD

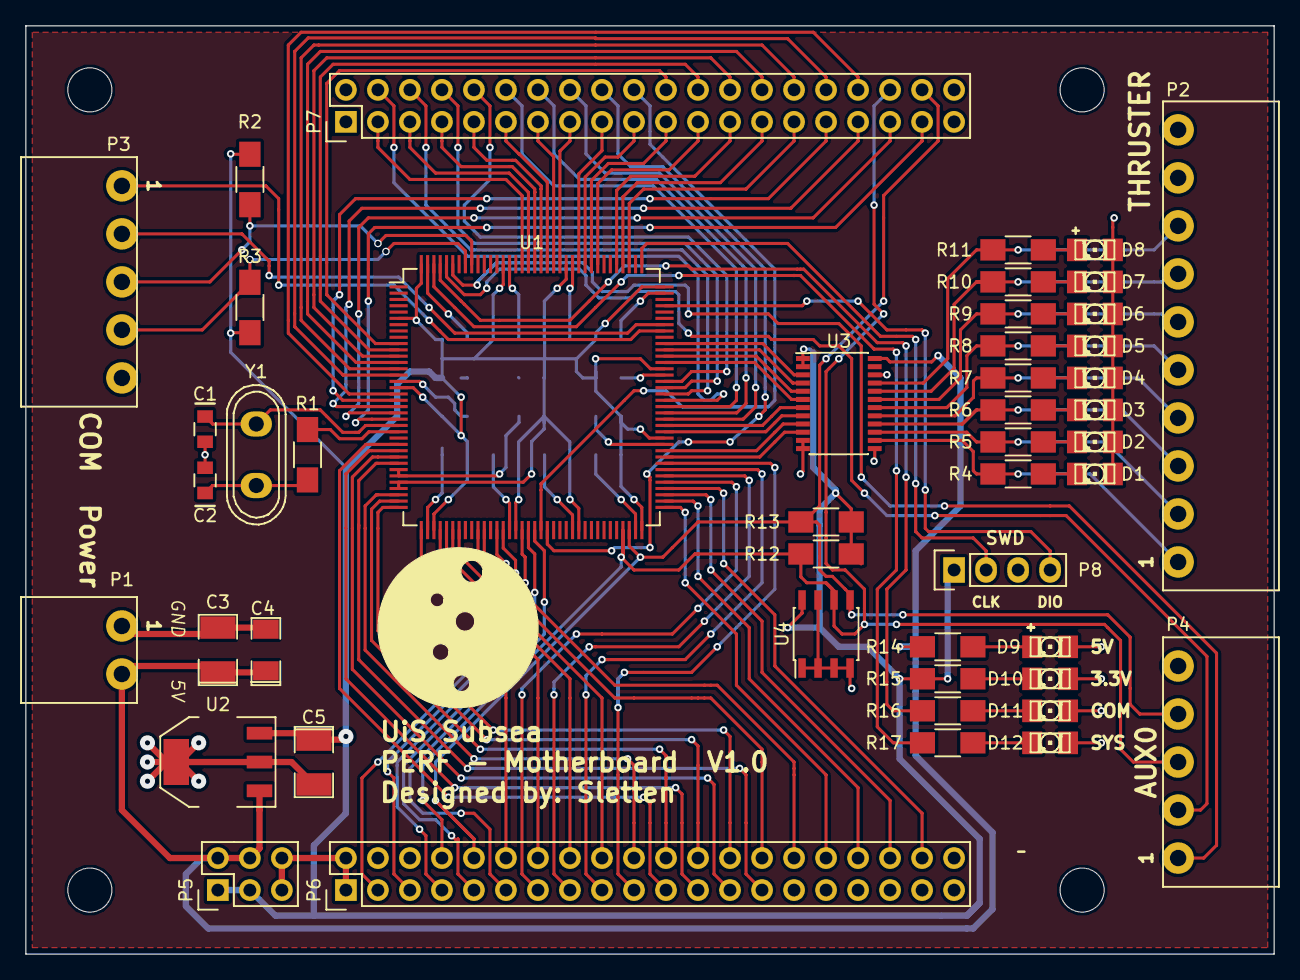
[picture p18: board Motherboard.kicad_pcb from above]

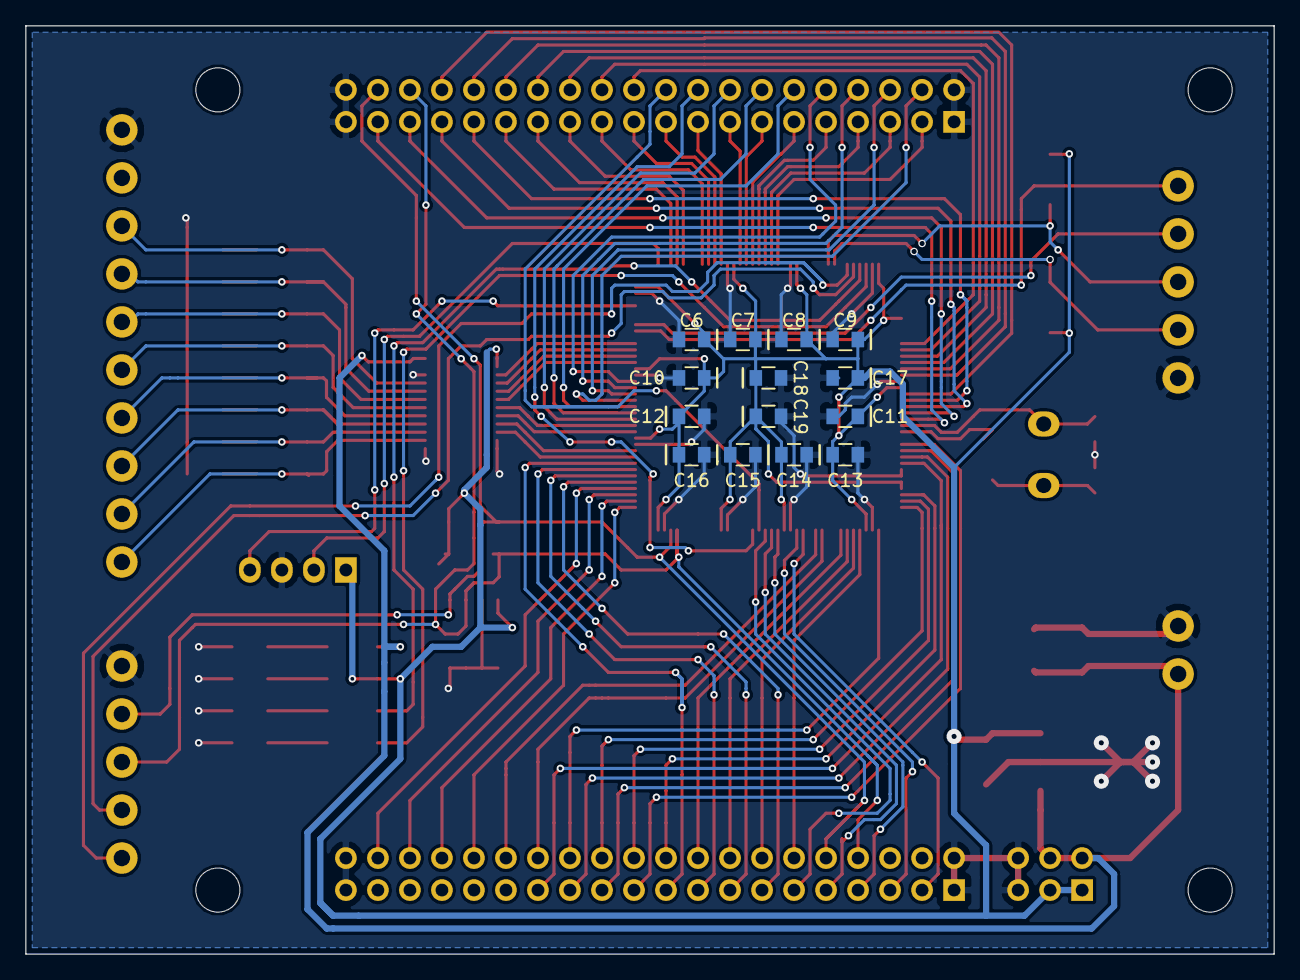
[picture p19: board Motherboard.kicad_pcb from below]

Board: 2 copper layers, 99.1 x 73.7 mm, 61 parts (14 on the bottom side), 107 nets.
