Sletten/STM_Perf/Hardware/KiCad/Perf/Backplane/Backplane.kicad_pcb

## KiCad design Hardware/KiCad/Perf/Backplane/Backplane.kicad_pcb (2015-06-03)

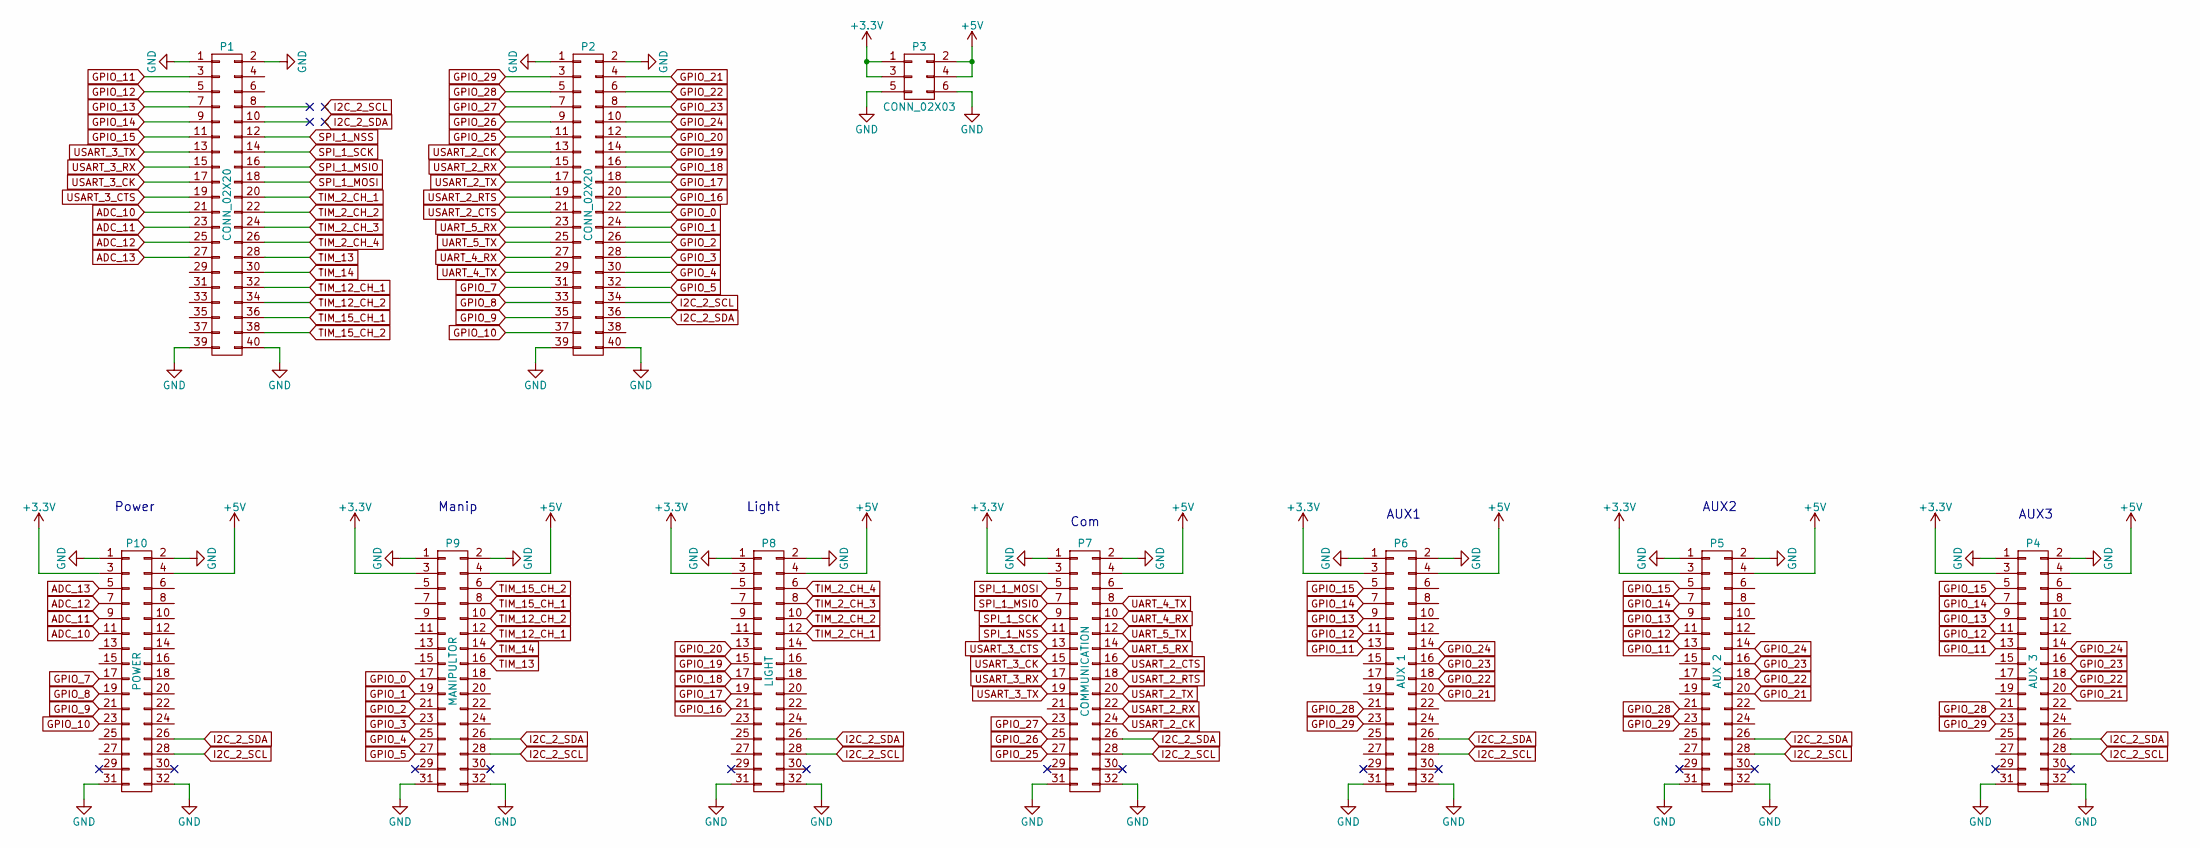
[picture p20: schematic Backplane.sch]

Parts:
P1, P2: CONN_02X20
P3: CONN_02X03
P4: AUX 3
P5: AUX 2
P6: AUX 1
P7: COMMUNICATION
P8: LIGHT
P9: MANIPULTOR
P10: POWER

Connections:
+3V3: P3.1, P3.3, P4.3, P5.3, P6.3, P7.3, P8.3, P9.3, P10.3
+5V: P3.2, P3.4, P4.4, P5.4, P6.4, P7.4, P8.4, P9.4, P10.4
ADC_10: P1.21, P10.11
ADC_11: P1.23, P10.9
ADC_12: P1.25, P10.7
ADC_13: P1.27, P10.5
GND: P1.1, P1.2, P1.39, P1.40, P2.1, P2.2, P2.39, P2.40, P3.5, P3.6, P4.1, P4.2, P4.31, P4.32, P5.1, P5.2, P5.31, P5.32, P6.1, P6.2, P6.31, P6.32, P7.1, P7.2, P7.31, P7.32, P8.1, P8.2, P8.31, P8.32, P9.1, P9.2, P9.31, P9.32, P10.1, P10.2, P10.31, P10.32
GPIO_0: P2.22, P9.17
GPIO_1: P2.24, P9.19
GPIO_2: P2.26, P9.21
GPIO_3: P2.28, P9.23
GPIO_4: P2.30, P9.25
GPIO_5: P2.32, P9.27
GPIO_7: P2.31, P10.17
GPIO_8: P2.33, P10.19
GPIO_9: P2.35, P10.21
GPIO_10: P2.37, P10.23
GPIO_11: P1.3, P4.13, P5.13, P6.13
GPIO_12: P1.5, P4.11, P5.11, P6.11
GPIO_13: P1.7, P4.9, P5.9, P6.9
GPIO_14: P1.9, P4.7, P5.7, P6.7
GPIO_15: P1.11, P4.5, P5.5, P6.5
GPIO_16: P2.20, P8.21
GPIO_17: P2.18, P8.19
GPIO_18: P2.16, P8.17
GPIO_19: P2.14, P8.15
GPIO_20: P2.12, P8.13
GPIO_21: P2.4, P4.20, P5.20, P6.20
GPIO_22: P2.6, P4.18, P5.18, P6.18
GPIO_23: P2.8, P4.16, P5.16, P6.16
GPIO_24: P2.10, P4.14, P5.14, P6.14
GPIO_25: P2.11, P7.27
GPIO_26: P2.9, P7.25
GPIO_27: P2.7, P7.23
GPIO_28: P2.5, P4.21, P5.21, P6.21
GPIO_29: P2.3, P4.23, P5.23, P6.23
I2C_2_SCL: P2.34, P4.28, P5.28, P6.28, P7.28, P8.28, P9.28, P10.28
I2C_2_SDA: P2.36, P4.26, P5.26, P6.26, P7.26, P8.26, P9.26, P10.26
SPI_1_MOSI: P1.18, P7.5
SPI_1_MSIO: P1.16, P7.7
SPI_1_NSS: P1.12, P7.11
SPI_1_SCK: P1.14, P7.9
TIM_2_CH_1: P1.20, P8.12
TIM_2_CH_2: P1.22, P8.10
TIM_2_CH_3: P1.24, P8.8
TIM_2_CH_4: P1.26, P8.6
TIM_12_CH_1: P1.32, P9.12
TIM_12_CH_2: P1.34, P9.10
TIM_13: P1.28, P9.16
TIM_14: P1.30, P9.14
TIM_15_CH_1: P1.36, P9.8
TIM_15_CH_2: P1.38, P9.6
UART_4_RX: P2.27, P7.10
UART_4_TX: P2.29, P7.8
UART_5_RX: P2.23, P7.14
UART_5_TX: P2.25, P7.12
USART_2_CK: P2.13, P7.24
USART_2_CTS: P2.21, P7.16
USART_2_RTS: P2.19, P7.18
USART_2_RX: P2.15, P7.22
USART_2_TX: P2.17, P7.20
USART_3_CK: P1.17, P7.15
USART_3_CTS: P1.19, P7.13
USART_3_RX: P1.15, P7.17
USART_3_TX: P1.13, P7.19

Notes on the sheet:
Power
Manip
Light
Com
AUX1
AUX2
AUX3

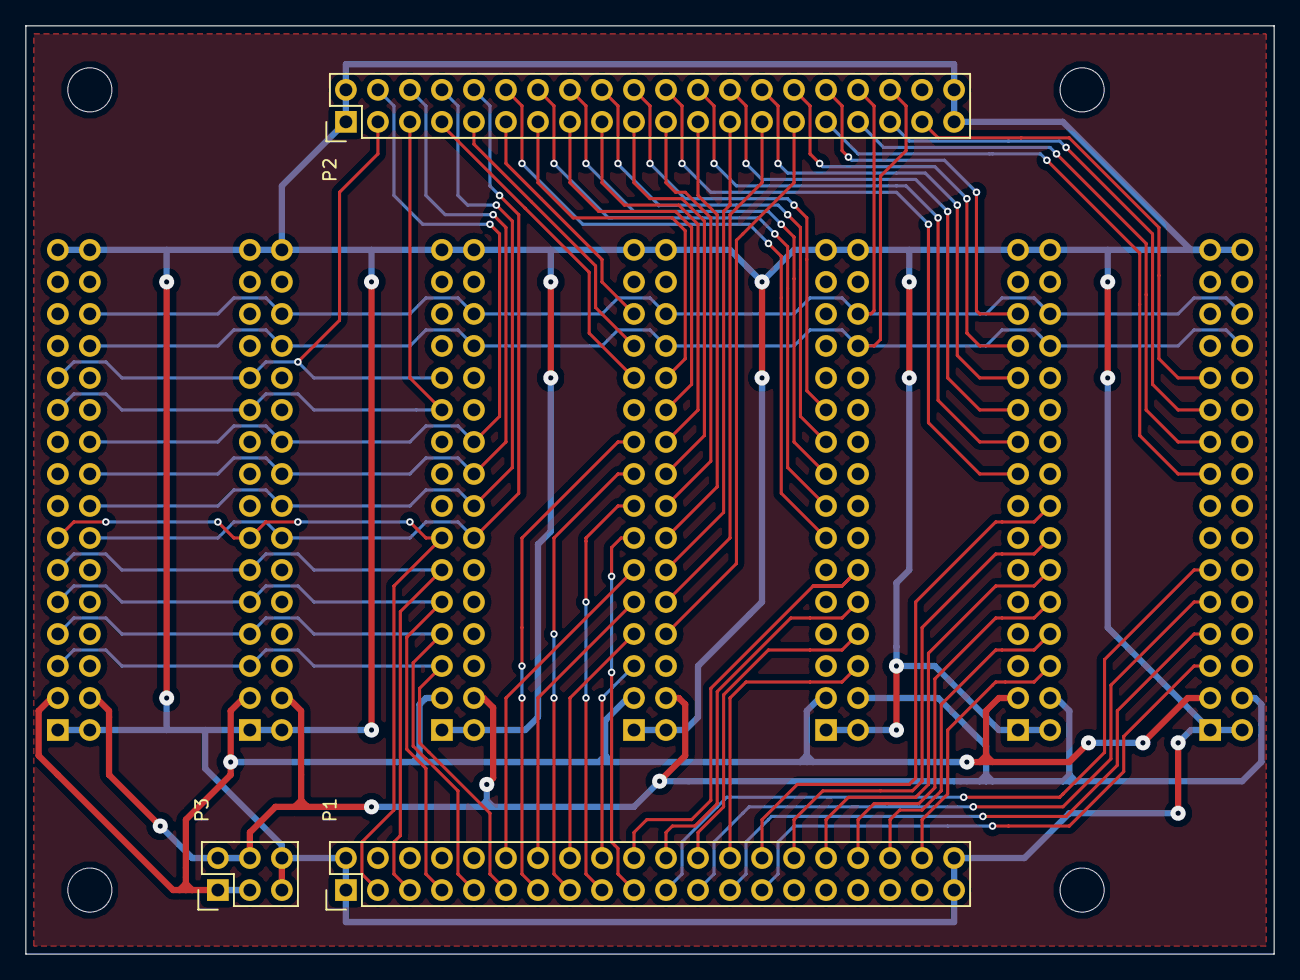
[picture p21: board Backplane.kicad_pcb from above]

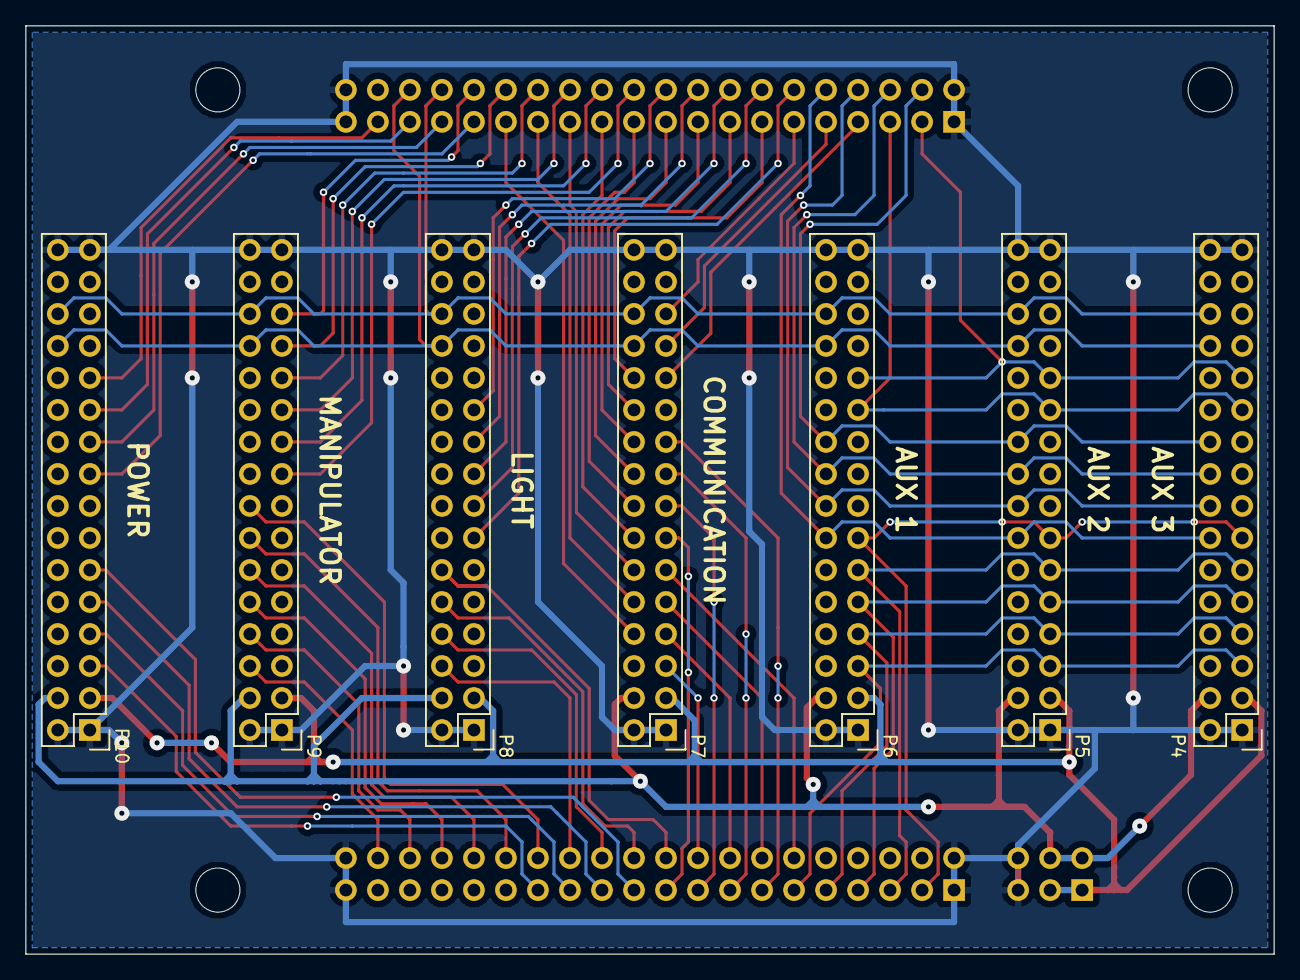
[picture p22: board Backplane.kicad_pcb from below]

Board: 2 copper layers, 99.1 x 73.7 mm, 10 parts (7 on the bottom side), 65 nets.
