Sletten/STM_Perf/Software/Perf/src/system_init.c

/*
 *
 *
 *
 *
 */

#include "system_init.h"
#include "thrusterSimple.h"



void systickInit(int inDelay);

void sysInit(void)
{

	sysComInit();
	sysGpioInit();
	sysTimInit();

	initThrusters();


	sysIrqInit();
}
