Sletten/STM_Perf/(commit log)

2015-05-20 Started electronics layout, planing of PERF modules
    [Backplane.kicad_pcb, Backplane.sch, Motherboard.sch, noname.sch]
2015-05-23 sdfghjkl
    sdfghjklø
    [Motherboard.kicad_pcb, Motherboard.sch]
2015-05-25 laying out motherboard and backplane
    [Backplane.kicad_pcb, Backplane.sch, Motherboard.kicad_pcb, Motherboard.ply, Motherboard.sch, Motherboard.stl]
2015-05-27 updated footprints and some layout
    [Backplane.kicad_pcb, Motherboard.kicad_pcb, Motherboard.sch]
2015-05-28 updated BOM
    [Motherboard.kicad_pcb]
2015-05-31 Small change to USART 2 pin layout from MB to Backplane
    [Backplane.kicad_pcb, Backplane.sch, Motherboard.kicad_pcb, Motherboard.sch]
2015-05-31 Fungerende kode, setter servo via uart
2015-06-02 completed backplane pcb
    [Backplane.kicad_pcb, Backplane.sch]
2015-06-03 Created gerber files for ordering
    [Backplane.kicad_pcb, Motherboard.kicad_pcb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]
2015-06-13 working on thruster code
2015-06-18 working on thruster system
    Trying to implement highly modular thruster system, but is facing some
    challenges with thruster scaling when maximum thrust is reached
2015-06-21 continued work on thruster control
2015-06-24 updated error in level shifter footprint
    [Motherboard-B_Cu.gbr, Motherboard-B_Mask.gbr, Motherboard-B_SilkS.gbr, Motherboard-Edge_Cuts.gbr, Motherboard-F_Cu.gbr, Motherboard-F_Mask.gbr, Motherboard-F_SilkS.gbr, Motherboard.drl]
2015-06-28 Fixed missign ground connection to level shifter
    [Motherboard.kicad_pcb]
2015-06-29 fixed adressing error on PERF eeprom
    [Motherboard.kicad_pcb, Motherboard.sch]
2015-07-05 updated gerber files
    [Motherboard-B_Cu.gbr, Motherboard-B_Mask.gbr, Motherboard-B_SilkS.gbr, Motherboard-Edge_Cuts.gbr, Motherboard-F_Cu.gbr, Motherboard-F_Mask.gbr, Motherboard-F_SilkS.gbr, Motherboard.drl]
2015-07-20 working on thruster software
2015-07-23 Updated Gerberfiles for produection
    [Backplane-B_Cu.gbr, Backplane-B_Mask.gbr, Backplane-B_SilkS.gbr, Backplane-Edge_Cuts.gbr, Backplane-F_Cu.gbr, Backplane-F_Mask.gbr, Backplane-F_SilkS.gbr, Backplane.drl]
2015-08-06 More work on scaling thruster vectoring, might have overcomplicated slightly, considering hardcode in the thruster setup
2015-08-14 Working on simplified thruster control
2015-08-29 Fixed fixed-point error in thruster code, and fixed rounding error
    [main.cpp]
2015-08-30 PERF thruster code, and general setup
    Implemented the thruster code to the PERF system, still need to set up
    the control of the pwm outputs.
    Fixed external crystal frequency, was HSE_Value set to 24Mhz, to get
    uart to work propperly. Probably fixed other potential errors.
    [com.c, fixpointLib.c, fixpointLib.h, main.cpp, system.c, thruster.c, thruster.h, thrusterSimple.c]
2015-09-05 Working on communication
    Implementing communication protocol
    setting up timer interrupt to catch error in recieving data when taking
    too long.
    [com.c, system.c, system_com.c, system_interrupt.c, system_tim.c, thrusterSimple.c, thrusterSimple.h]
2015-09-27 startign on i2c communication
2015-10-10 Stuff is working!
    Fixed thruster scaling where dividing by zero, and rounding messed up
    the calculation.
    PWM scaling to fit servo output fixed and working.
    [Motherboard.sch]
2015-10-14 fix for thruster scaling.
    changed temp scale from 16bit to 32bit
    [thrusterSimple.c]
2015-10-17 Started schematic of power distribution PERF_module
    [Power.sch]
2015-10-18 some modification to clean up thruster code
2015-10-22 Cleaned up thruster code, and added some explaination
    Cleaned up the code, and made it more independent of the system such as
    setting the registers for the timer outputs.
    Some experimental code needs to be tested.
    Added explaination of the code, so should be easier to understand
2015-10-25 Tesing uis subsea logo on pcb design
    [Motherboard.kicad_pcb]
2015-10-25 More work on thruster code
    Added prototype og esc configurator, needs to be tested and timed
    correctly
    Some polishing on the new untested stuff
    [com.c, eeprom.c, eeprom.h, thrusterSimple.c, thrusterSimple.h]
2016-05-06 Fixed i2c 1 layout error
    Fixed wrong pin layout for i2c1
    [Motherboard.kicad_pcb, Motherboard.sch]
